paradajz/Zvuk9/hw/Zvuk9_R2.pdf

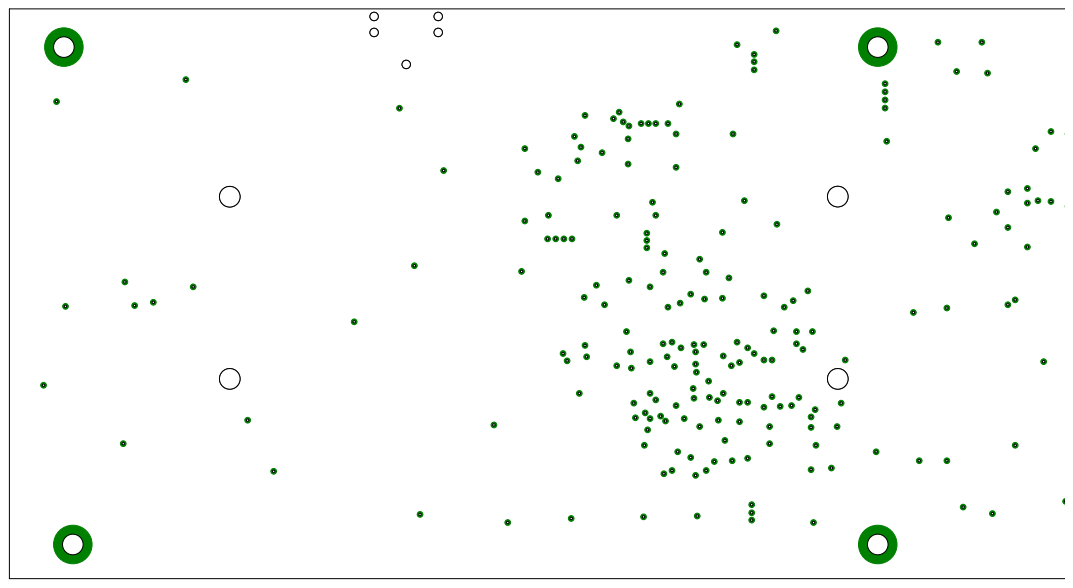
[picture p1: page 1]

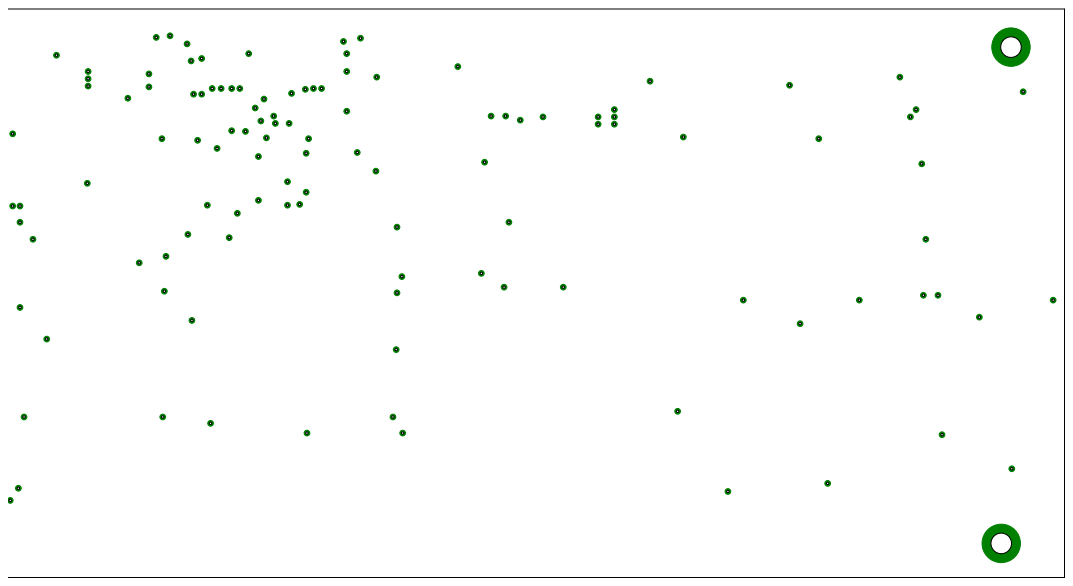
[picture p2: page 2]
