paradajz/Zvuk9/hw/Zvuk9_R2.brd

## EAGLE design hw/Zvuk9_R2.brd (2021-06-12)

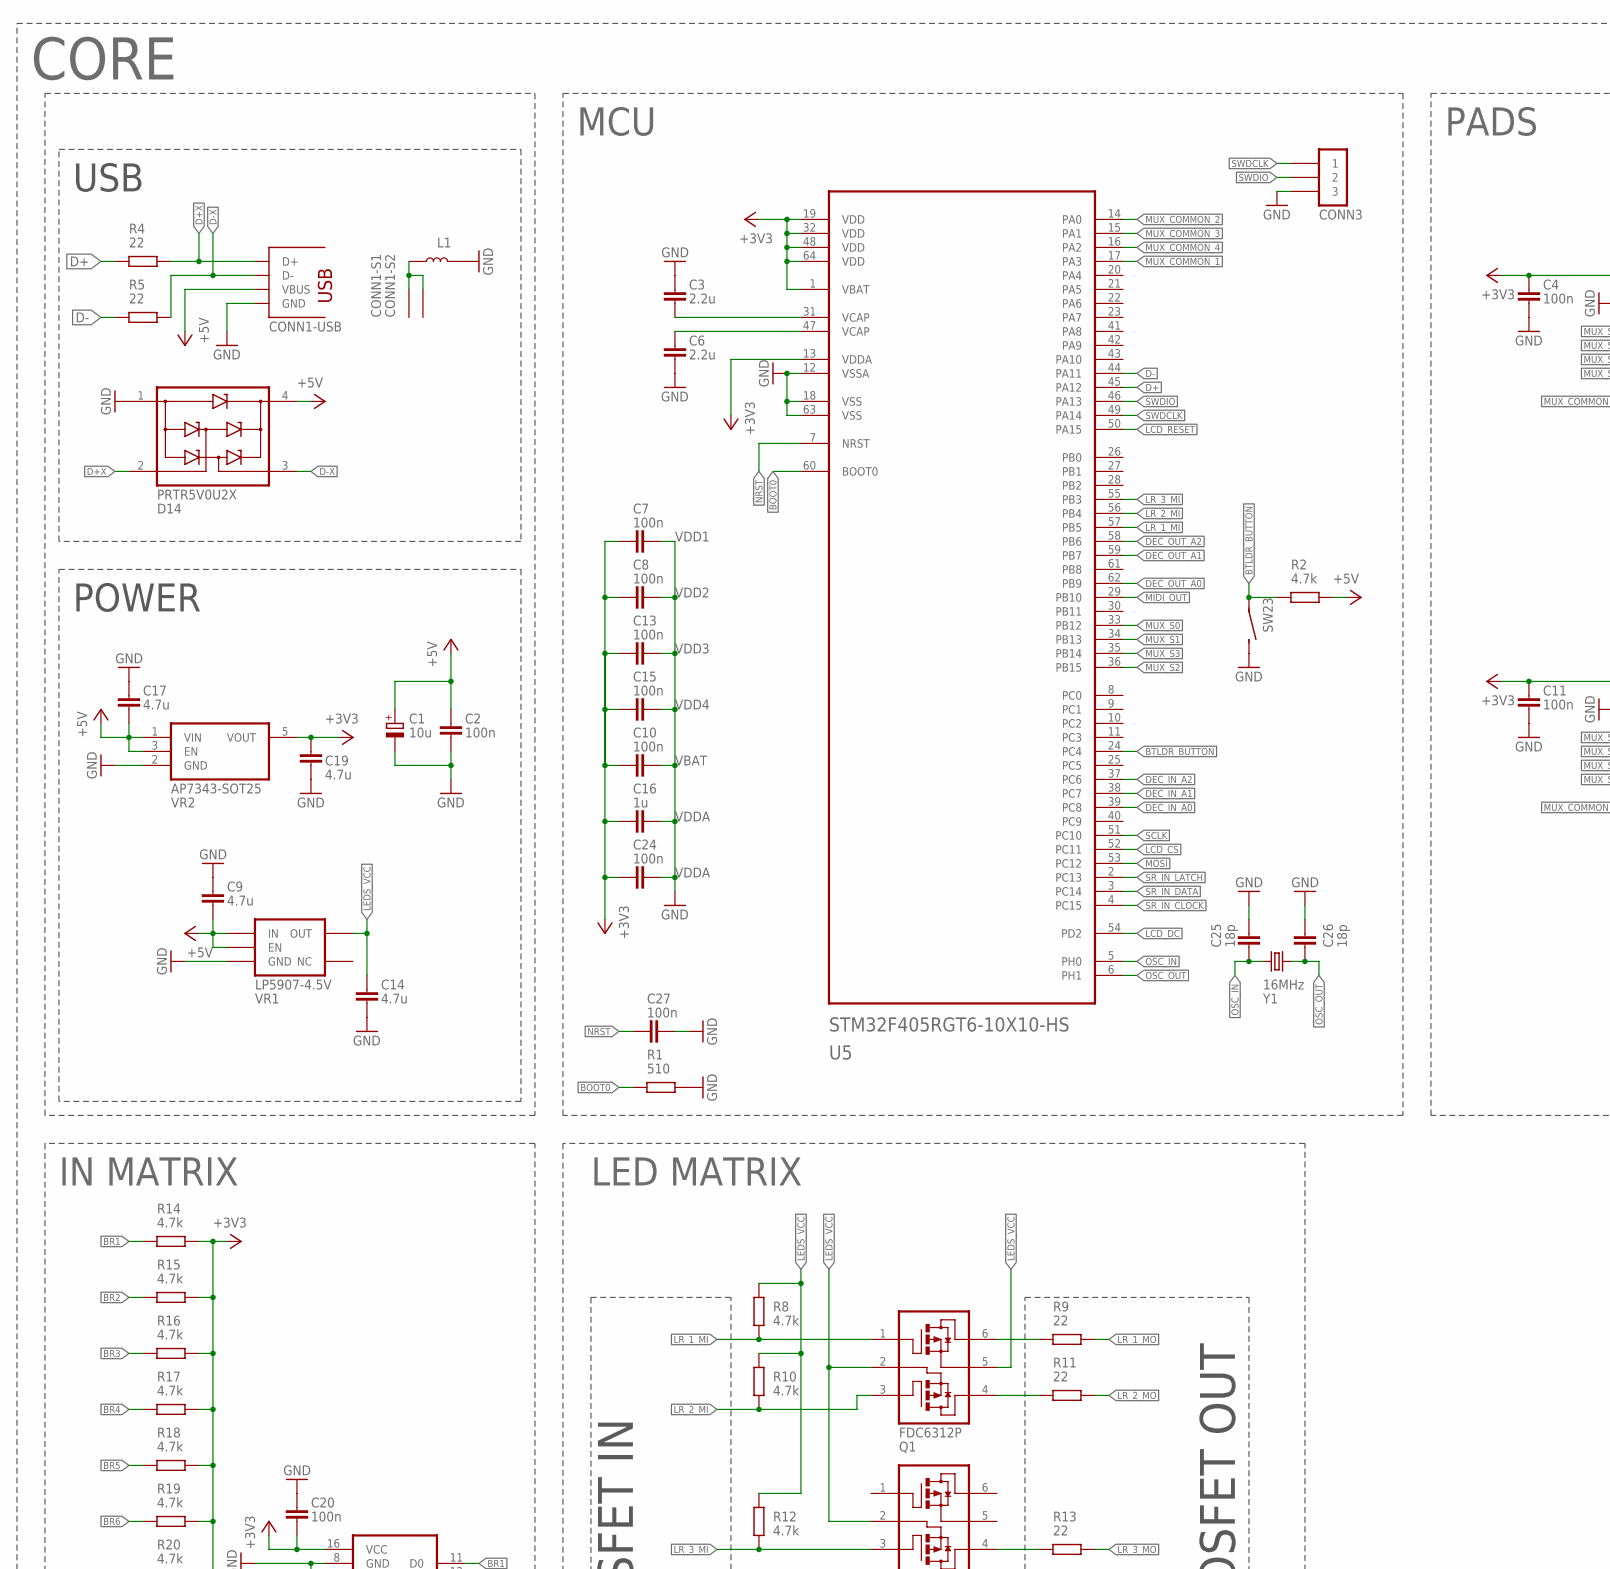
[picture p3: schematic Zvuk9_R2.sch, part in row 1, column 1]

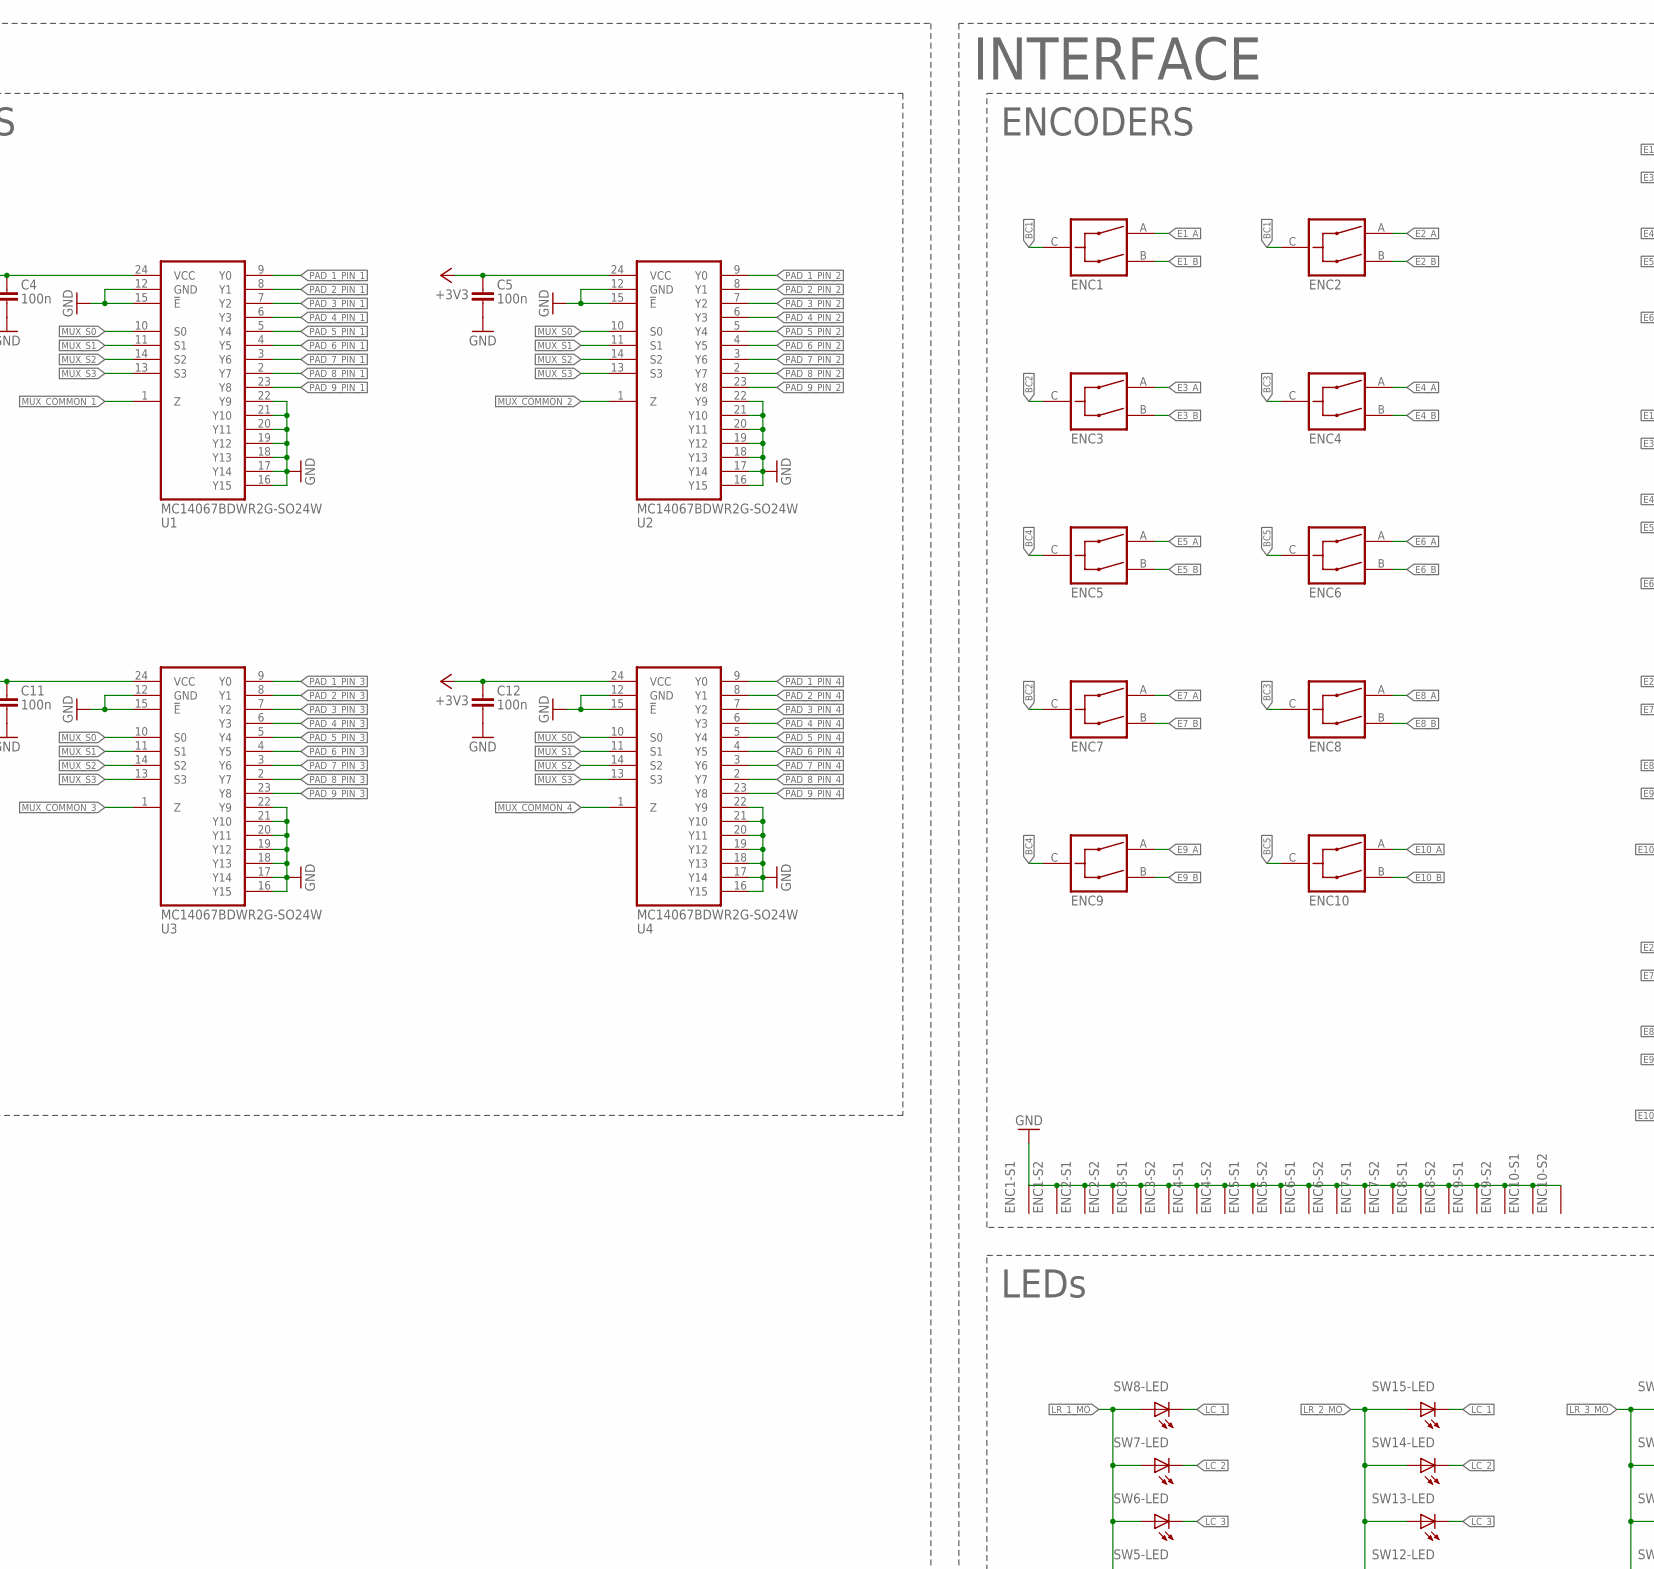
[picture p4: schematic Zvuk9_R2.sch, part in row 1, column 2]

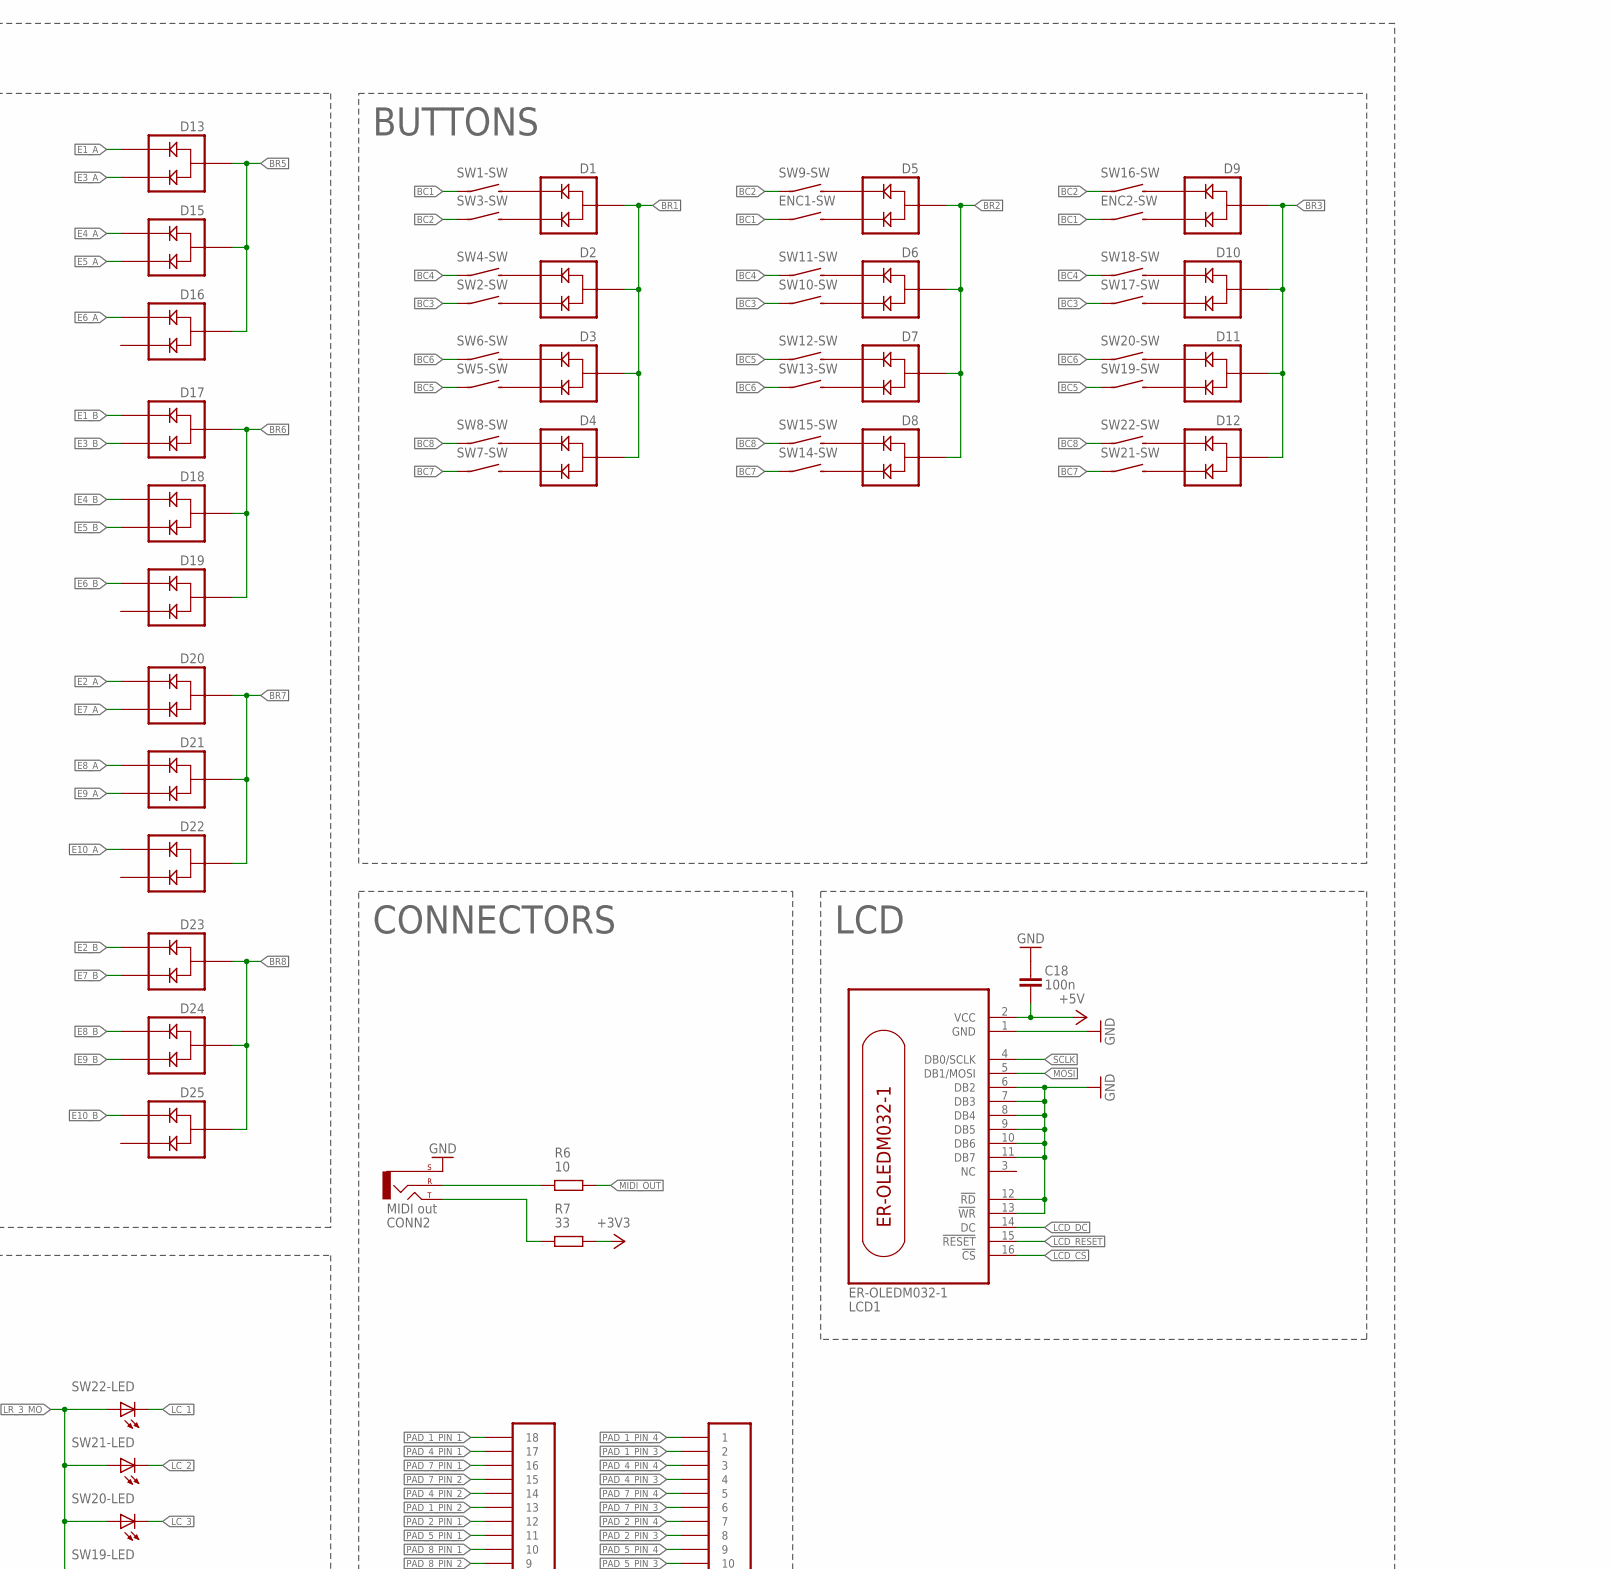
[picture p5: schematic Zvuk9_R2.sch, part in row 1, column 3]

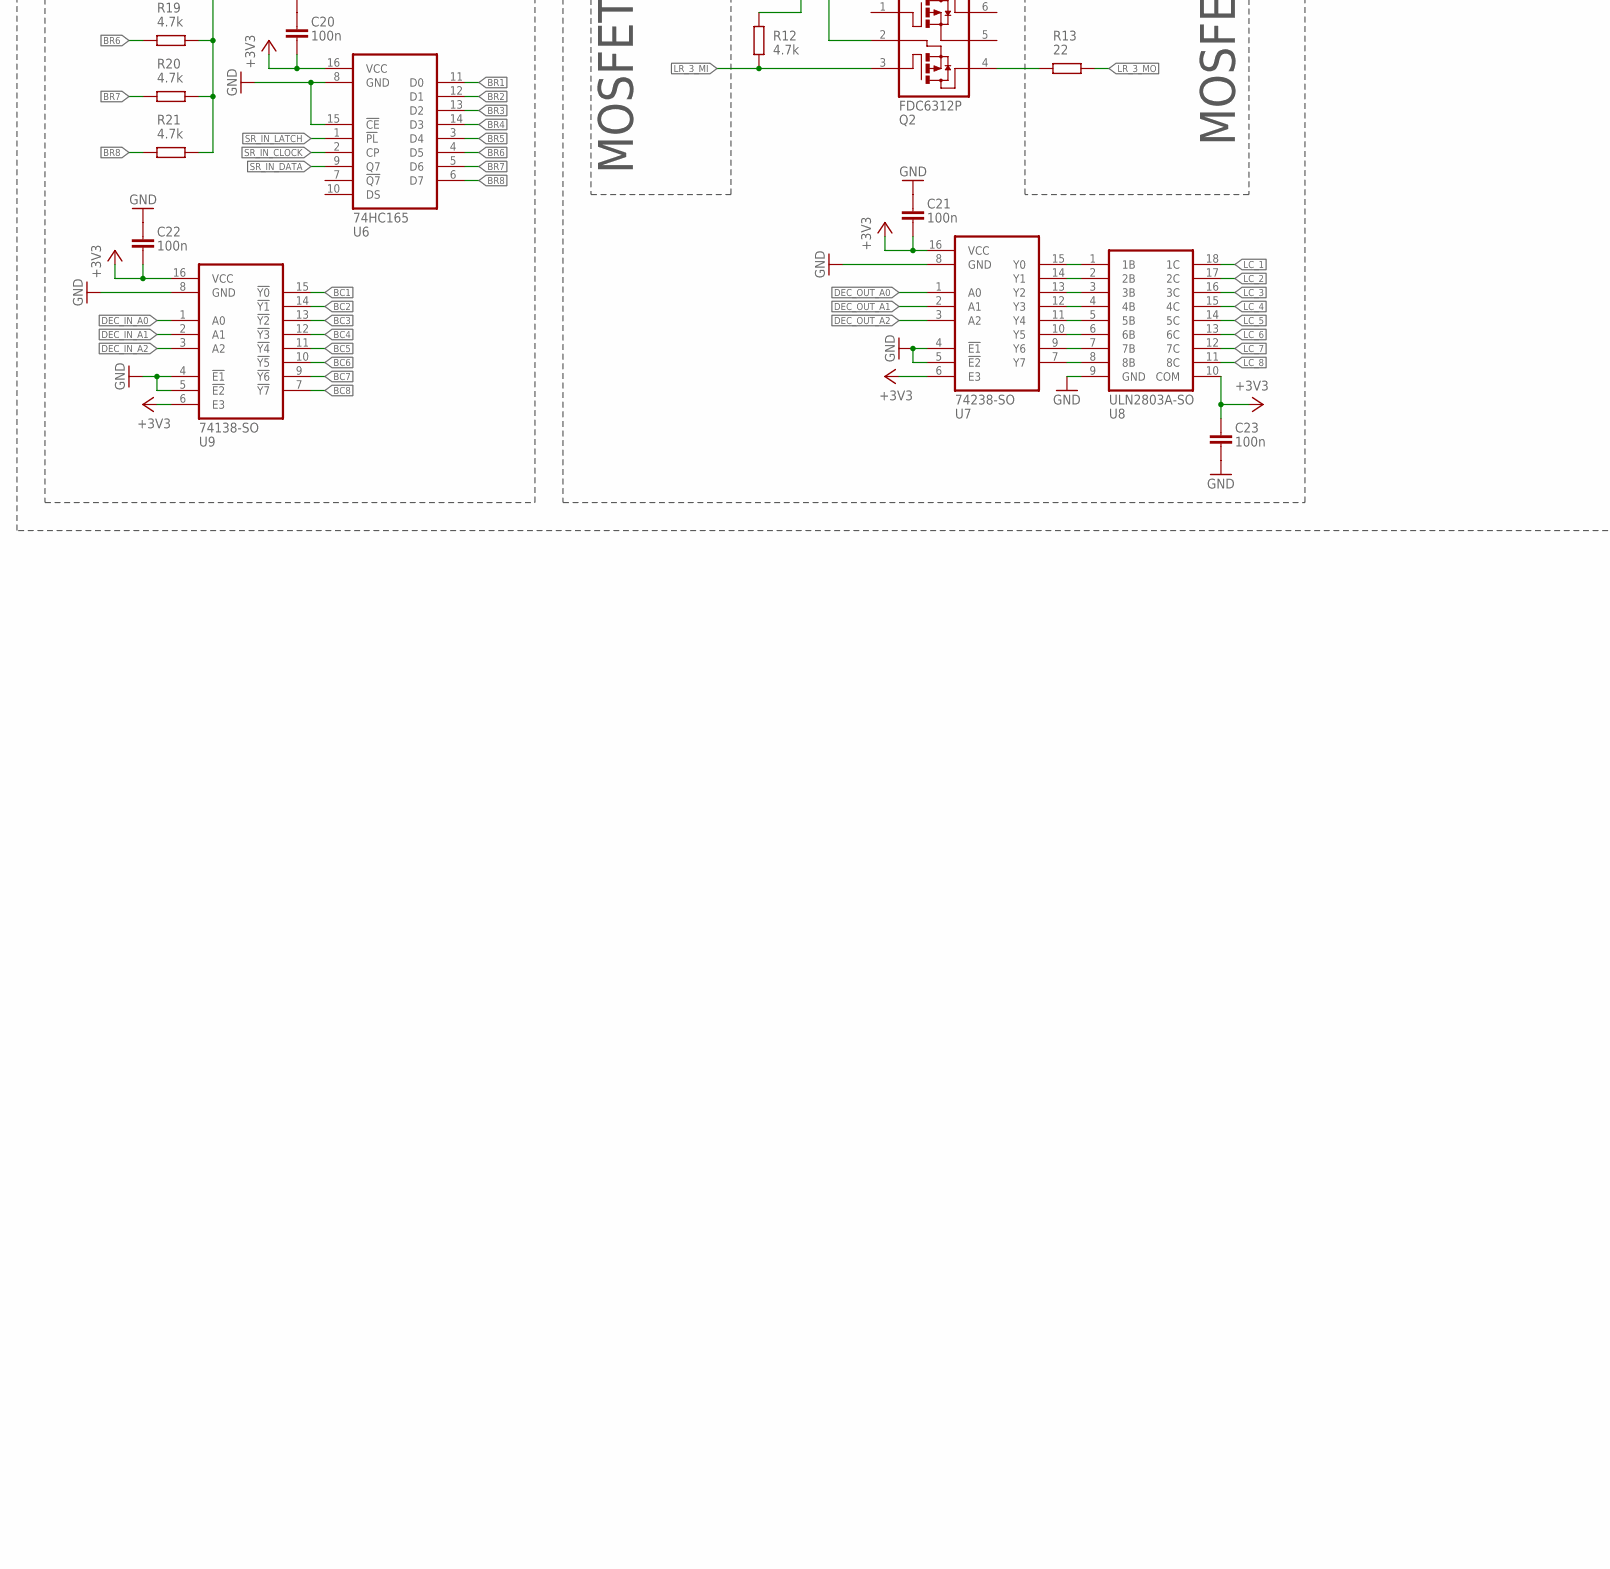
[picture p6: schematic Zvuk9_R2.sch, part in row 2, column 1]

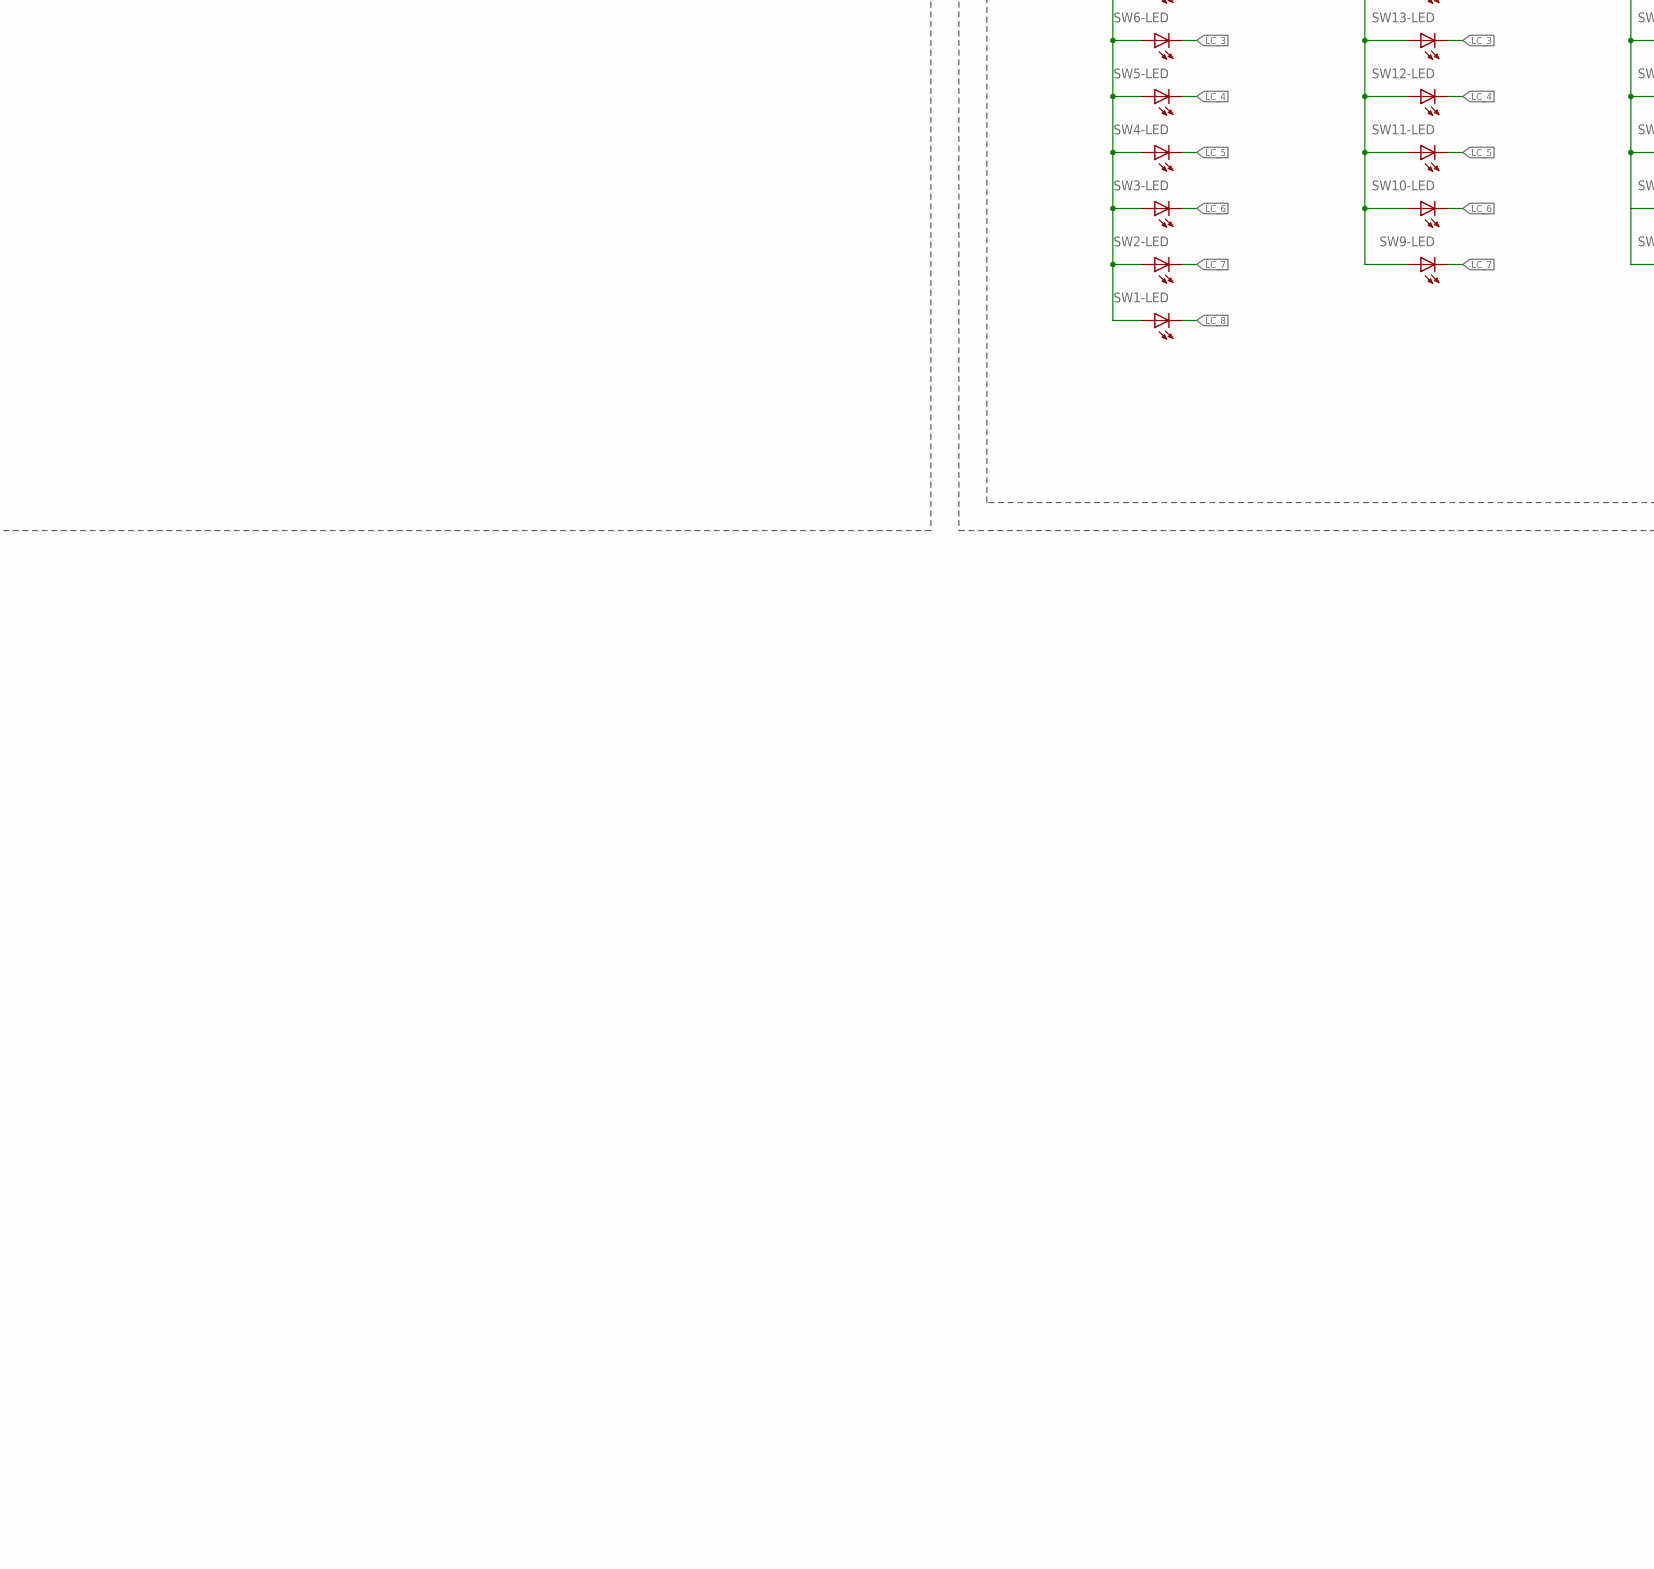
[picture p7: schematic Zvuk9_R2.sch, part in row 2, column 2]

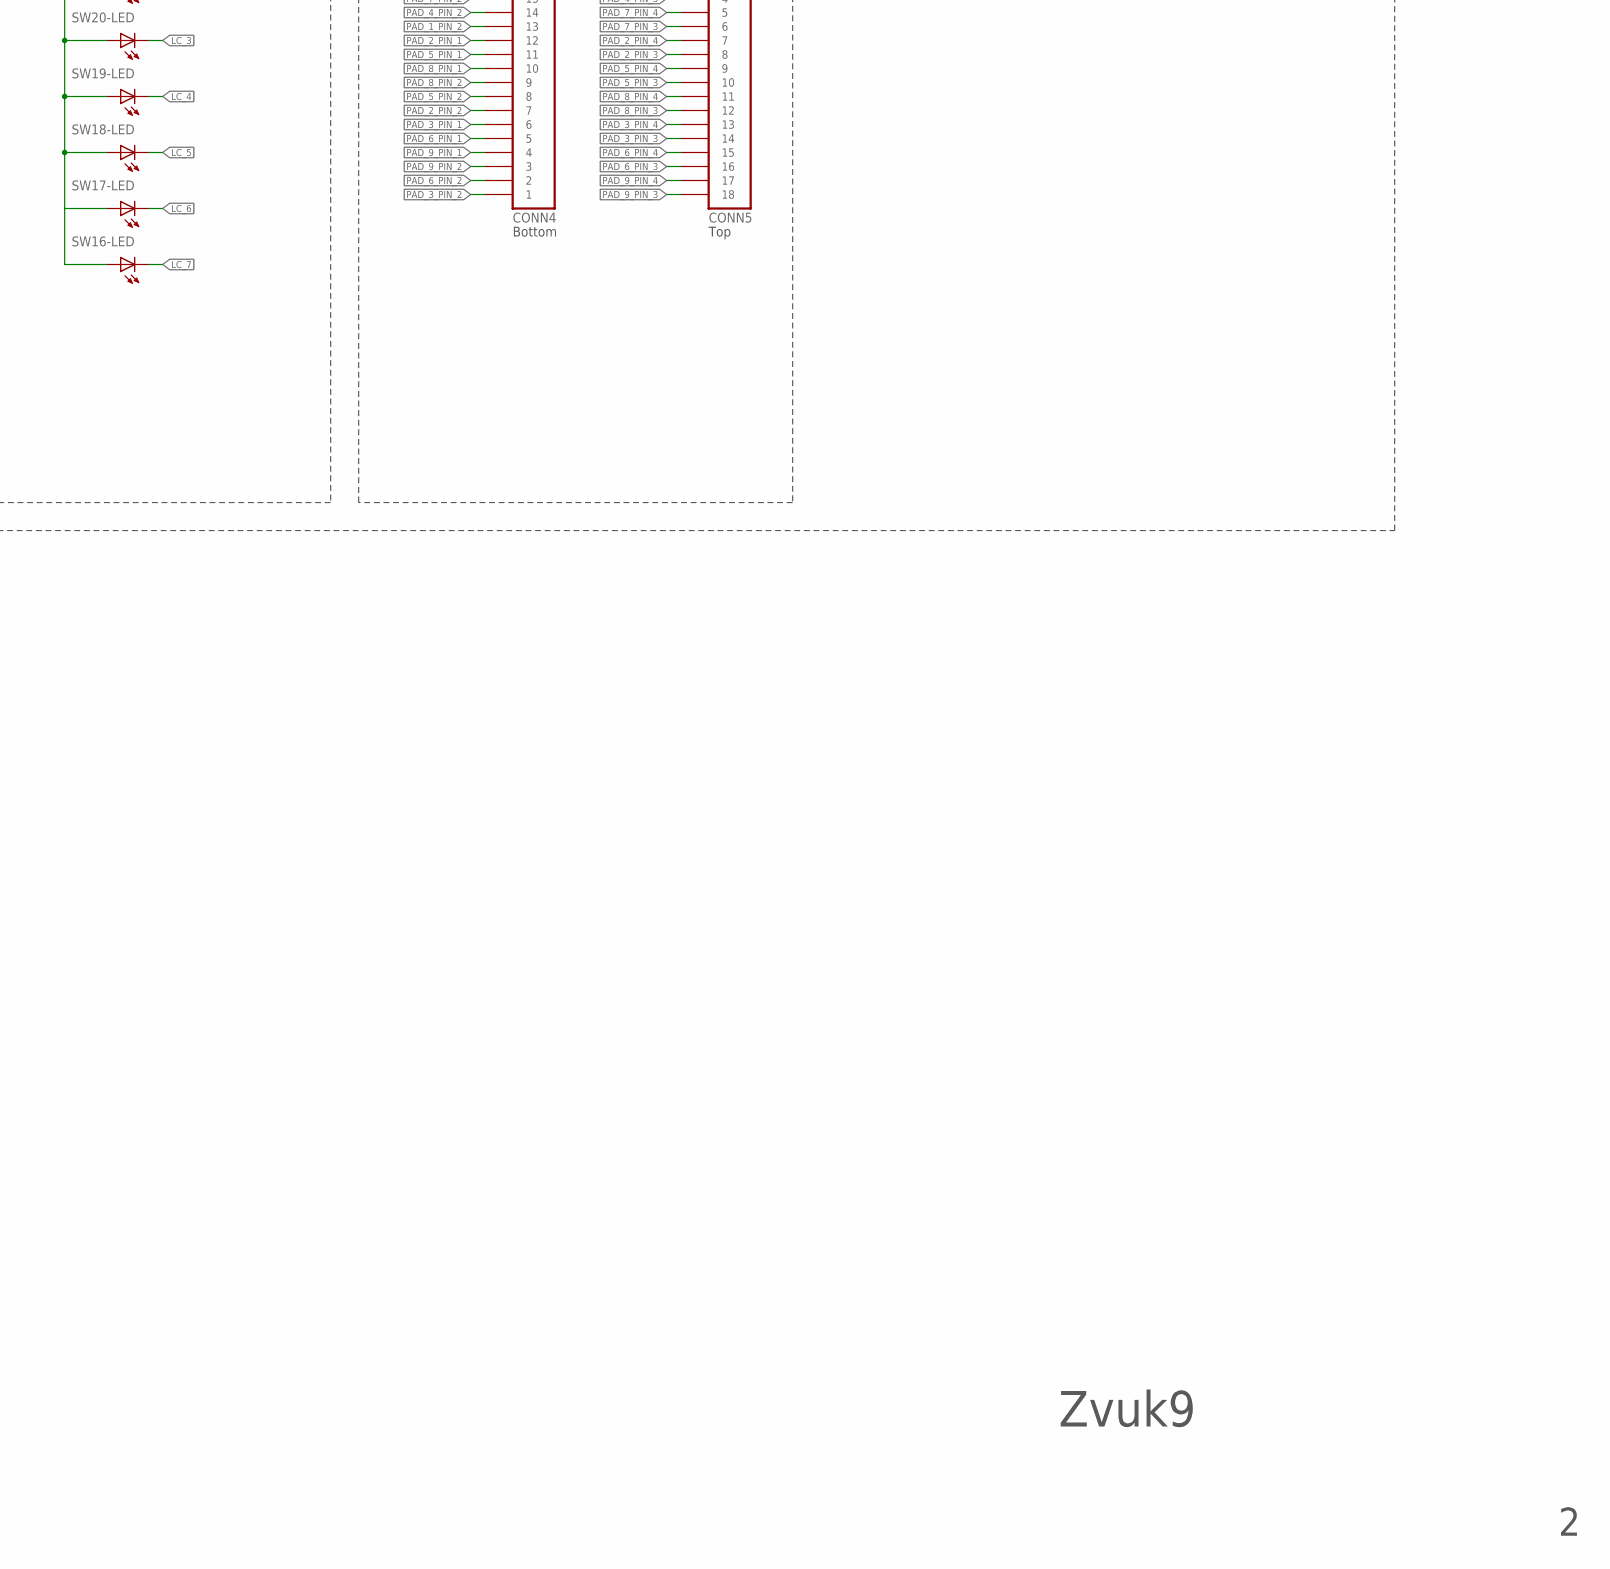
[picture p8: schematic Zvuk9_R2.sch, part in row 2, column 3]

Parts:
C1: 10u; C-TH-E-0502
C2, C4, C5, C7, C8, C10, C11, C12, C13, C15, C18, C20, C21, C22, C23, C24, C27: 100n; C0805
C3, C6: 2.2u; C0805
C9, C14, C17, C19: 4.7u; C0805
C16: 1u; C0805
C25, C26: 18p; C0805
CONN1: USB-B-H; USB-B-PTH
CONN2: MIDI out; SJ1-3523N
CONN3: PINHD-1X03-TH-2.54MM; 1X03-2.54-V
CONN4, CONN5: PINHD-1X18-FFC-SMD-1MM; MOLEX-52271-1879
D1, D2, D3, D4, D5, D6, D7, D8, D9, D10, D11, D12, D13, D15, D16, D17, D18, D19, D20, D21, D22, D23, D24, D25: BAW56; SOT23
D14: PRTR5V0U2X; SOT143
ENC1, ENC2: ALPS-EC12D1524403; ALPS_EC12-SW
ENC3, ENC4, ENC5, ENC6, ENC7, ENC8, ENC9, ENC10: ALPS-EC12E24404AX; EC12E-1
L1: FERRITE_BEAD-BLM21PG221SN1D; L0805
LCD1: ER-OLEDM032-1; ER-OLEDM032-W
Q1, Q2: FDC6312P; SSOT6
R1: 510; R0805
R2, R8, R10, R12, R14, R15, R16, R17, R18, R19, R20, R21: 4.7k; R0805
R4, R5, R9, R11, R13: 22; R0805
R6: 10; R0805
R7: 33; R0805
SW1, SW2, SW3, SW4, SW5, SW6, SW7, SW8, SW9, SW10, SW11, SW12, SW13, SW14, SW15, SW16, SW17, SW18, SW19, SW20, SW21, SW22: OMRON-B3W-9
SW23: SWITCH-B3F; B3F-312X
U1, U2, U3, U4: MC14067BDWR2G-SO24W; SO24-W
U5: STM32F405RGT6-10X10-HS; TQFP-64-10X10-HS
U6: 74HC165; SO16
U7: 74238-SO; SO16
U8: ULN2803A-SO; SO18
U9: 74138-SO; SO16
VR1: LP5907-4.5V; SOT23-5
VR2: AP7343-SOT25; SOT25
Y1: 16MHz; HC49US

Connections:
+3V3: C4.1, C5.1, C7.1, C8.1, C10.1, C11.1, C12.1, C13.1, C15.1, C16.1, C19.1, C20.2, C21.2, C22.2, C23.1, C24.1, R7.2, R14.2, R15.2, R16.2, R17.2, R18.2, R19.2, R20.2, R21.2, U1.24 (VCC), U2.24 (VCC), U3.24 (VCC), U4.24 (VCC), U5.1 (VBAT), U5.13 (VDDA), U5.19 (VDD), U5.32 (VDD), U5.48 (VDD), U5.64 (VDD), U6.16 (VCC), U7.6 (E3), U7.16 (VCC), U8.10 (COM), U9.6 (E3), U9.16 (VCC), VR2.5 (VOUT)
+5V: C1.+, C2.1, C9.2, C17.2, C18.2, CONN1.VBUS, D14.4 (VCC), LCD1.2 (VCC), R2.2, VR1.1 (IN), VR1.3 (EN), VR2.1 (VIN), VR2.3 (EN)
BC1: ENC1.C, ENC1.D (1), ENC2.C, ENC2.D (1), SW1.1, U9.15 (!Y0)
BC2: ENC3.C, ENC7.C, SW3.1, SW9.1, SW16.1, U9.14 (!Y1)
BC3: ENC4.C, ENC8.C, SW2.1, SW10.1, SW17.1, U9.13 (!Y2)
BC4: ENC5.C, ENC9.C, SW4.1, SW11.1, SW18.1, U9.12 (!Y3)
BC5: ENC6.C, ENC10.C, SW5.1, SW12.1, SW19.1, U9.11 (!Y4)
BC6: SW6.1, SW13.1, SW20.1, U9.10 (!Y5)
BC7: SW7.1, SW14.1, SW21.1, U9.9 (!Y6)
BC8: SW8.1, SW15.1, SW22.1, U9.7 (!Y7)
BOOT0: R1.1, U5.60 (BOOT0)
BR1: D1.3, D2.3, D3.3, D4.3, R14.1, U6.11 (D0)
BR2: D5.3, D6.3, D7.3, D8.3, R15.1, U6.12 (D1)
BR3: D9.3, D10.3, D11.3, D12.3, R16.1, U6.13 (D2)
BR4: R17.1, U6.14 (D3)
BR5: D13.3, D15.3, D16.3, R18.1, U6.3 (D4)
BR6: D17.3, D18.3, D19.3, R19.1, U6.4 (D5)
BR7: D20.3, D21.3, D22.3, R20.1, U6.5 (D6)
BR8: D23.3, D24.3, D25.3, R21.1, U6.6 (D7)
BTLDR_BUTTON: R2.1, SW23.1, U5.24 (PC4)
D+: R4.1, U5.45 (PA12)
D+X: CONN1.D+, D14.2 (I/O1), R4.2
D-: R5.1, U5.44 (PA11)
D-X: CONN1.D-, D14.3 (I/O2), R5.2
DEC_IN_A0: U5.39 (PC8), U9.1 (A0)
DEC_IN_A1: U5.38 (PC7), U9.2 (A1)
DEC_IN_A2: U5.37 (PC6), U9.3 (A2)
DEC_OUT_A0: U5.62 (PB9), U7.1 (A0)
DEC_OUT_A1: U5.59 (PB7), U7.2 (A1)
DEC_OUT_A2: U5.58 (PB6), U7.3 (A2)
E1_A: D13.1, ENC1.A
E1_B: D17.1, ENC1.B
E2_A: D20.1, ENC2.A
E2_B: D23.1, ENC2.B
E3_A: D13.2, ENC3.A
E3_B: D17.2, ENC3.B
E4_A: D15.1, ENC4.A
E4_B: D18.1, ENC4.B
E5_A: D15.2, ENC5.A
E5_B: D18.2, ENC5.B
E6_A: D16.1, ENC6.A
E6_B: D19.1, ENC6.B
E7_A: D20.2, ENC7.A
E7_B: D23.2, ENC7.B
E8_A: D21.1, ENC8.A
E8_B: D24.1, ENC8.B
E9_A: D21.2, ENC9.A
E9_B: D24.2, ENC9.B
E10_A: D22.1, ENC10.A
E10_B: D25.1, ENC10.B
GND: C1.-, C2.2, C3.1, C4.2, C5.2, C6.2, C7.2, C8.2, C9.1, C10.2, C11.2, C12.2, C13.2, C14.2, C15.2, C16.2, C17.1, C18.1, C19.2, C20.1, C21.1, C22.1, C23.2, C24.2, C25.2, C26.2, C27.2, CONN1.GND, CONN2.1 (SLEEVE), CONN3.3, D14.1 (GND), ENC1.S1 (S), ENC1.S2 (S), ENC2.S1 (S), ENC2.S2 (S), ENC3.S1 (S), ENC3.S2 (S), ENC4.S1 (S), ENC4.S2 (S), ENC5.S1 (S), ENC5.S2 (S), ENC6.S1 (S), ENC6.S2 (S), ENC7.S1 (S), ENC7.S2 (S), ENC8.S1 (S), ENC8.S2 (S), ENC9.S1 (S), ENC9.S2 (S), ENC10.S1 (S), ENC10.S2 (S), L1.2, LCD1.1 (GND), LCD1.6 (DB2), LCD1.7 (DB3), LCD1.8 (DB4), LCD1.9 (DB5), LCD1.10 (DB6), LCD1.11 (DB7), LCD1.12 (!RD), LCD1.13 (!WR), R1.2, SW23.2, U1.12 (GND), U1.15 (!E), U1.16 (Y15), U1.17 (Y14), U1.18 (Y13), U1.19 (Y12), U1.20 (Y11), U1.21 (Y10), U1.22 (Y9), U2.12 (GND), U2.15 (!E), U2.16 (Y15), U2.17 (Y14), U2.18 (Y13), U2.19 (Y12), U2.20 (Y11), U2.21 (Y10), U2.22 (Y9), U3.12 (GND), U3.15 (!E), U3.16 (Y15), U3.17 (Y14), U3.18 (Y13), U3.19 (Y12), U3.20 (Y11), U3.21 (Y10), U3.22 (Y9), U4.12 (GND), U4.15 (!E), U4.16 (Y15), U4.17 (Y14), U4.18 (Y13), U4.19 (Y12), U4.20 (Y11), U4.21 (Y10), U4.22 (Y9), U5.12 (VSSA), U5.18 (VSS), U5.63 (VSS), U6.8 (GND), U6.15 (!CE), U7.4 (!E1), U7.5 (!E2), U7.8 (GND), U8.9 (GND), U9.4 (!E1), U9.5 (!E2), U9.8 (GND), VR1.2 (GND), VR2.2 (GND)
LCD_CS: LCD1.16 (!CS), U5.52 (PC11)
LCD_DC: LCD1.14 (DC), U5.54 (PD2)
LCD_RESET: LCD1.15 (!RESET), U5.50 (PA15)
LC_1: SW8.6-C (C), SW15.6-C (C), SW22.6-C (C), U8.18 (1C)
LC_2: SW7.6-C (C), SW14.6-C (C), SW21.6-C (C), U8.17 (2C)
LC_3: SW6.6-C (C), SW13.6-C (C), SW20.6-C (C), U8.16 (3C)
LC_4: SW5.6-C (C), SW12.6-C (C), SW19.6-C (C), U8.15 (4C)
LC_5: SW4.6-C (C), SW11.6-C (C), SW18.6-C (C), U8.14 (5C)
LC_6: SW3.6-C (C), SW10.6-C (C), SW17.6-C (C), U8.13 (6C)
LC_7: SW2.6-C (C), SW9.6-C (C), SW16.6-C (C), U8.12 (7C)
LC_8: SW1.6-C (C), U8.11 (8C)
LEDS_VCC: C14.1, Q1.2 (S2), Q1.5 (S1), Q2.2 (S2), R8.1, R10.1, R12.1, VR1.5 (OUT)
LR_1_MI: Q1.1 (G1), R8.2, U5.57 (PB5)
LR_1_MO: R9.2, SW1.6-A (A), SW2.6-A (A), SW3.6-A (A), SW4.6-A (A), SW5.6-A (A), SW6.6-A (A), SW7.6-A (A), SW8.6-A (A)
LR_2_MI: Q1.3 (G2), R10.2, U5.56 (PB4)
LR_2_MO: R11.2, SW9.6-A (A), SW10.6-A (A), SW11.6-A (A), SW12.6-A (A), SW13.6-A (A), SW14.6-A (A), SW15.6-A (A)
LR_3_MI: Q2.3 (G2), R12.2, U5.55 (PB3)
LR_3_MO: R13.2, SW16.6-A (A), SW17.6-A (A), SW18.6-A (A), SW19.6-A (A), SW20.6-A (A), SW21.6-A (A), SW22.6-A (A)
MIDI_OUT: R6.2, U5.29 (PB10)
MOSI: LCD1.5 (DB1/MOSI), U5.53 (PC12)
MUX_COMMON_1: U1.1 (Z), U5.17 (PA3)
MUX_COMMON_2: U2.1 (Z), U5.14 (PA0)
MUX_COMMON_3: U3.1 (Z), U5.15 (PA1)
MUX_COMMON_4: U4.1 (Z), U5.16 (PA2)
MUX_S0: U1.10 (S0), U2.10 (S0), U3.10 (S0), U4.10 (S0), U5.33 (PB12)
MUX_S1: U1.11 (S1), U2.11 (S1), U3.11 (S1), U4.11 (S1), U5.34 (PB13)
MUX_S2: U1.14 (S2), U2.14 (S2), U3.14 (S2), U4.14 (S2), U5.36 (PB15)
MUX_S3: U1.13 (S3), U2.13 (S3), U3.13 (S3), U4.13 (S3), U5.35 (PB14)
unnamed: U7.15 (Y0), U8.1 (1B)
unnamed: U7.14 (Y1), U8.2 (2B)
unnamed: U7.13 (Y2), U8.3 (3B)
unnamed: U7.12 (Y3), U8.4 (4B)
unnamed: D1.1, SW1.3 (2)
unnamed: D2.2, SW2.3 (2)
unnamed: CONN2.2 (TIP), R7.1
unnamed: D2.1, SW4.3 (2)
unnamed: D1.2, SW3.3 (2)
unnamed: D3.2, SW5.3 (2)
unnamed: D3.1, SW6.3 (2)
unnamed: C3.2, U5.31 (VCAP)
unnamed: C6.1, U5.47 (VCAP)
unnamed: D4.2, SW7.3 (2)
unnamed: D4.1, SW8.3 (2)
unnamed: D5.2, ENC1.E (2)
unnamed: D6.2, SW10.3 (2)
unnamed: D6.1, SW11.3 (2)
unnamed: D7.1, SW12.3 (2)
unnamed: D7.2, SW13.3 (2)
unnamed: D8.2, SW14.3 (2)
unnamed: D8.1, SW15.3 (2)
unnamed: D5.1, SW9.3 (2)
unnamed: D9.2, ENC2.E (2)
unnamed: D9.1, SW16.3 (2)
unnamed: D10.2, SW17.3 (2)
unnamed: D10.1, SW18.3 (2)
unnamed: D11.2, SW19.3 (2)
unnamed: D11.1, SW20.3 (2)
unnamed: D12.2, SW21.3 (2)
unnamed: D12.1, SW22.3 (2)
unnamed: CONN2.3 (RING), R6.1
unnamed: U7.11 (Y4), U8.5 (5B)
unnamed: U7.10 (Y5), U8.6 (6B)
unnamed: U7.9 (Y6), U8.7 (7B)
unnamed: U7.7 (Y7), U8.8 (8B)
unnamed: Q1.6 (D1), R9.1
unnamed: Q1.4 (D2), R11.1
unnamed: Q2.4 (D2), R13.1
NRST: C27.1, U5.7 (NRST)
OSC_IN: C25.1, U5.5 (PH0), Y1.1
OSC_OUT: C26.1, U5.6 (PH1), Y1.2
PAD_1_PIN_1: CONN4.18, U1.9 (Y0)
PAD_1_PIN_2: CONN4.13, U2.9 (Y0)
PAD_1_PIN_3: CONN5.2, U3.9 (Y0)
PAD_1_PIN_4: CONN5.1, U4.9 (Y0)
PAD_2_PIN_1: CONN4.12, U1.8 (Y1)
PAD_2_PIN_2: CONN4.7, U2.8 (Y1)
PAD_2_PIN_3: CONN5.8, U3.8 (Y1)
PAD_2_PIN_4: CONN5.7, U4.8 (Y1)
PAD_3_PIN_1: CONN4.6, U1.7 (Y2)
PAD_3_PIN_2: CONN4.1, U2.7 (Y2)
PAD_3_PIN_3: CONN5.14, U3.7 (Y2)
PAD_3_PIN_4: CONN5.13, U4.7 (Y2)
PAD_4_PIN_1: CONN4.17, U1.6 (Y3)
PAD_4_PIN_2: CONN4.14, U2.6 (Y3)
PAD_4_PIN_3: CONN5.4, U3.6 (Y3)
PAD_4_PIN_4: CONN5.3, U4.6 (Y3)
PAD_5_PIN_1: CONN4.11, U1.5 (Y4)
PAD_5_PIN_2: CONN4.8, U2.5 (Y4)
PAD_5_PIN_3: CONN5.10, U3.5 (Y4)
PAD_5_PIN_4: CONN5.9, U4.5 (Y4)
PAD_6_PIN_1: CONN4.5, U1.4 (Y5)
PAD_6_PIN_2: CONN4.2, U2.4 (Y5)
PAD_6_PIN_3: CONN5.16, U3.4 (Y5)
PAD_6_PIN_4: CONN5.15, U4.4 (Y5)
PAD_7_PIN_1: CONN4.16, U1.3 (Y6)
PAD_7_PIN_2: CONN4.15, U2.3 (Y6)
PAD_7_PIN_3: CONN5.6, U3.3 (Y6)
PAD_7_PIN_4: CONN5.5, U4.3 (Y6)
PAD_8_PIN_1: CONN4.10, U1.2 (Y7)
PAD_8_PIN_2: CONN4.9, U2.2 (Y7)
PAD_8_PIN_3: CONN5.12, U3.2 (Y7)
PAD_8_PIN_4: CONN5.11, U4.2 (Y7)
PAD_9_PIN_1: CONN4.4, U1.23 (Y8)
PAD_9_PIN_2: CONN4.3, U2.23 (Y8)
PAD_9_PIN_3: CONN5.18, U3.23 (Y8)
PAD_9_PIN_4: CONN5.17, U4.23 (Y8)
SCLK: LCD1.4 (DB0/SCLK), U5.51 (PC10)
SR_IN_CLOCK: U5.4 (PC15), U6.2 (CP)
SR_IN_DATA: U5.3 (PC14), U6.9 (Q7)
SR_IN_LATCH: U5.2 (PC13), U6.1 (!PL)
SWDCLK: CONN3.1, U5.49 (PA14)
SWDIO: CONN3.2, U5.46 (PA13)
USB_SHIELD: CONN1.S1 (S), CONN1.S2 (S), L1.1

Notes on the sheet:
LCD
BUTTONS
ENCODERS
CONNECTORS
Zvuk9
LEDs
USB
MOSFET IN
MOSFET OUT
MCU
POWER
IN MATRIX
LED MATRIX
CORE
INTERFACE
PADS
Bottom
Top
VBAT
VDD1
VDD2
VDD3
VDD4
VDDA

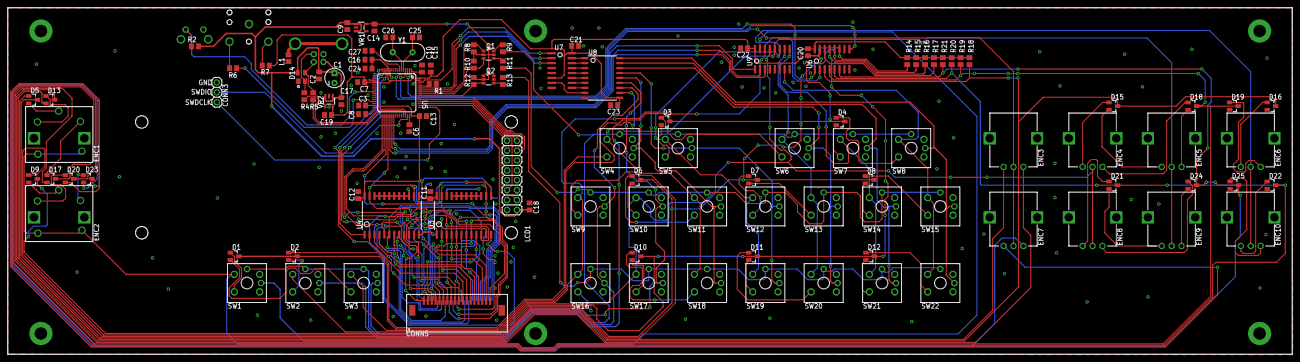
[picture p9: board Zvuk9_R2.brd from above]

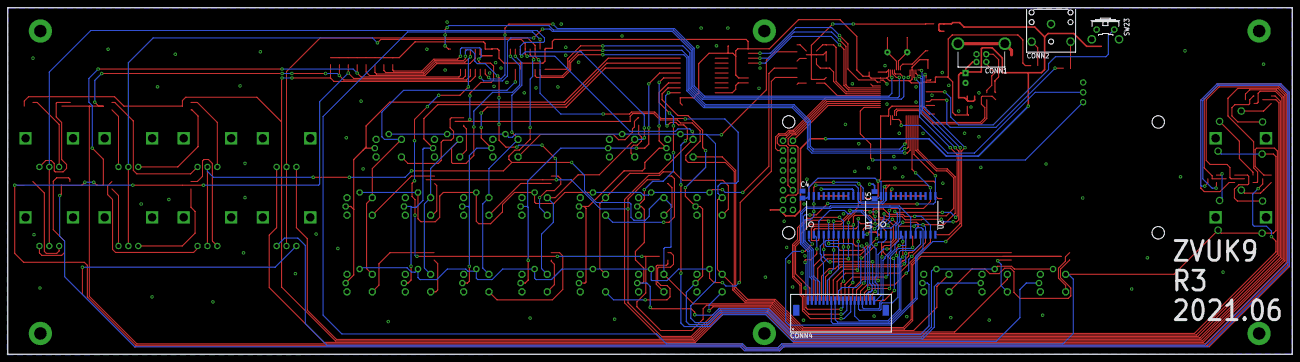
[picture p10: board Zvuk9_R2.brd from below]

Board: 2 copper layers, 330.1 x 89.0 mm, 126 parts (8 on the bottom side), 164 nets.
