paradajz/Zvuk9/src/application/io/encoders/Encoders.cpp

/*
    Zvuk9 MIDI controller
    Copyright (C) 2014-2017 Ad Bit LLC
    Author: Igor Petrović
    
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
    You may ONLY use this file:
    1) if you have a valid commercial Ad Bit LLC license and then in accordance with
    the terms contained in the written license agreement between you and Ad Bit LLC,
    or alternatively
    2) if you follow the terms found in GNU General Public License version 3 as
    published by the Free Software Foundation here
    <https://www.gnu.org/licenses/gpl-3.0.txt>
*/

#include "Encoders.h"
#include "../../../display/menu/Menu.h"
#include "handlers/Handlers.h"
#include "pins/map/Encoders.h"
#include "core/src/general/Timing.h"
#include "board/Board.h"

/// \ingroup interfaceEncoders
/// @{

/// External definition of function pointers used as handlers for encoders.
extern void (*encoderHandler[MAX_NUMBER_OF_ENCODERS])(uint8_t id, int8_t steps);

/// When set to true, preset encoder is used to change MIDI channels instead of presets.
bool midiChannelEncState;

/// Array holding last time in milliseconds encoders were moved.
uint32_t lastStepTime[MAX_NUMBER_OF_ENCODERS];

/// Array holding current speed (in steps) for all encoders.
/// Set to 1 by default.
int8_t encoderSpeed[MAX_NUMBER_OF_ENCODERS];

/// @}

/// Default constructor.
Encoders::Encoders()
{
}

/// Initializes Encoders object.
void Encoders::init()
{
    initHandlers_encoders();
}

/// Continuously checks state of all encoders.
void Encoders::update(bool process)
{
    int8_t steps;

    for (int i = 0; i < MAX_NUMBER_OF_ENCODERS; i++)
    {
        //process only enabled encoders
        if (!board.encoderEnabled(i))
            continue;

        steps = board.getEncoderState(i);

        if (steps == 0)
            continue;

        //when time difference between two movements is smaller than SPEED_TIMEOUT,
        //start accelerating
        if ((rTimeMs() - lastStepTime[i]) < SPEED_TIMEOUT)
        {
            encoderSpeed[i] += ENCODER_SPEED_CHANGE;
            steps = steps > 0 ? encoderSpeed[i] : -encoderSpeed[i];
        }
        else
        {
            encoderSpeed[i] = 0;
        }

        //allow only program and scale encoder while in menu
        //no message on display? maybe TO-DO
        if (menu.isMenuDisplayed())
        {
            if (!((i == PROGRAM_ENCODER) || (i == X_MAX_ENCODER) || (i == X_MIN_ENCODER) || (i == Y_MAX_ENCODER) || (i == Y_MIN_ENCODER)))
                continue;
        }

        if (encoderHandler[i] != NULL)
        {
            if (process)
                (*encoderHandler[i])(i, steps);
            lastStepTime[i] = rTimeMs();
        }
    }

    //disable midi channel function when regular text gets shown on display
    if (midiChannelEncState && (display.getActiveTextType() == displayText_still))
        midiChannelEncState = false;
}

/// Enables or disables MIDI channel changing mode for preset encoder.
/// @param[in] state    If set to true, preset encoder will be used to change MIDI channels.
///                     Otherwise, presets are changed using this encoder.
void Encoders::setMIDIchannelPresetEncMode(bool state)
{
    midiChannelEncState = state;
}

/// Checks if MIDI channel changing mode for preset encoder is enabled.
/// \returns True if MIDI channel changing mode is enabled, false otherwise.
bool Encoders::getMIDIchannelPresetEncMode()
{
    return midiChannelEncState;
}
