paradajz/Zvuk9/src/application/board/avr/Pins.h

/*
    Zvuk9 MIDI controller
    Copyright (C) 2014-2017 Ad Bit LLC
    Author: Igor Petrović
    
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
    You may ONLY use this file:
    1) if you have a valid commercial Ad Bit LLC license and then in accordance with
    the terms contained in the written license agreement between you and Ad Bit LLC,
    or alternatively
    2) if you follow the terms found in GNU General Public License version 3 as
    published by the Free Software Foundation here
    <https://www.gnu.org/licenses/gpl-3.0.txt>
*/

#pragma once

///
/// \brief Pin definitions.
/// \defgroup boardPins Pins
/// \ingroup boardAVR
/// @{

#define MUX_COMMON_PIN_0_PORT       PORTF
#define MUX_COMMON_PIN_0_PIN        7

#define MUX_COMMON_PIN_1_PORT       PORTF
#define MUX_COMMON_PIN_1_PIN        5

#define MUX_COMMON_PIN_2_PORT       PORTF
#define MUX_COMMON_PIN_2_PIN        6

#define MUX_COMMON_PIN_3_PORT       PORTF
#define MUX_COMMON_PIN_3_PIN        4

///
/// \brief Symbolic names for common mux ports.
/// @{

#define PAD_PLATE_X_PLUS_PORT       MUX_COMMON_PIN_0_PORT
#define PAD_PLATE_X_PLUS_PIN        MUX_COMMON_PIN_0_PIN

#define PAD_PLATE_X_MINUS_PORT      MUX_COMMON_PIN_1_PORT
#define PAD_PLATE_X_MINUS_PIN       MUX_COMMON_PIN_1_PIN

#define PAD_PLATE_Y_PLUS_PORT       MUX_COMMON_PIN_2_PORT
#define PAD_PLATE_Y_PLUS_PIN        MUX_COMMON_PIN_2_PIN

#define PAD_PLATE_Y_MINUS_PORT      MUX_COMMON_PIN_3_PORT
#define PAD_PLATE_Y_MINUS_PIN       MUX_COMMON_PIN_3_PIN

/// @}

#define MUX_SELECT_PIN_0_PORT       PORTF
#define MUX_SELECT_PIN_0_PIN        1

#define MUX_SELECT_PIN_1_PORT       PORTF
#define MUX_SELECT_PIN_1_PIN        0

#define MUX_SELECT_PIN_2_PORT       PORTF
#define MUX_SELECT_PIN_2_PIN        2

#define MUX_SELECT_PIN_3_PORT       PORTF
#define MUX_SELECT_PIN_3_PIN        3

#define LED_ROW_1_PORT              PORTB
#define LED_ROW_1_PIN               4

#define LED_ROW_2_PORT              PORTB
#define LED_ROW_2_PIN               5

#define LED_ROW_3_PORT              PORTB
#define LED_ROW_3_PIN               6

#define DECODER_OUT_1_PORT          PORTC
#define DECODER_OUT_1_PIN           0

#define DECODER_OUT_2_PORT          PORTC
#define DECODER_OUT_2_PIN           1

#define DECODER_OUT_3_PORT          PORTC
#define DECODER_OUT_3_PIN           2

#define DECODER_OUT_PORT            PORTC

///
/// Used to clear all select bits in decoder which controls columns in LED matrix.
/// This exploits the fact that all three decoder pins are on the same port on MCU,
/// wired consecutively.
///
#define DECODER_OUT_CLEAR_MASK      0b11111000

///
/// \brief Array holding all 8 states for output decoder.
/// Used to manipulate decoder select pins in a faster way.
///
const uint8_t decoderOutOrderArray[] =
{
    0b00000000,
    0b00000001,
    0b00000010,
    0b00000011,
    0b00000100,
    0b00000101,
    0b00000110,
    0b00000111
};

#define DECODER_IN_A0_PORT          PORTC
#define DECODER_IN_A0_PIN           3

#define DECODER_IN_A1_PORT          PORTC
#define DECODER_IN_A1_PIN           4

#define DECODER_IN_A2_PORT          PORTC
#define DECODER_IN_A2_PIN           5

#define DECODER_IN_PORT             PORTC

///
/// Used to clear all select bits in decoder which controls columns in button matrix.
/// This exploits the fact that all three decoder pins are on the same port on MCU,
/// wired consecutively.
///
#define DECODER_IN_CLEAR_MASK       0b11000111

///
/// \brief Array holding all 8 states for input decoder.
/// Used to manipulate decoder select pins in a faster way.
///
const uint8_t decoderInOrderArray[] =
{
    0b00000000,
    0b00001000,
    0b00010000,
    0b00011000,
    0b00100000,
    0b00101000,
    0b00110000,
    0b00111000
};

#define INPUT_SHIFT_REG_IN_PORT     PORTD
#define INPUT_SHIFT_REG_IN_PIN      5

#define INPUT_SHIFT_REG_CLOCK_PORT  PORTD
#define INPUT_SHIFT_REG_CLOCK_PIN   6

#define INPUT_SHIFT_REG_LATCH_PORT  PORTD
#define INPUT_SHIFT_REG_LATCH_PIN   7

#define DISPLAY_DC_PORT             PORTA
#define DISPLAY_DC_PIN              3

#define DISPLAY_CS_PORT             PORTA
#define DISPLAY_CS_PIN              4

#define DISPLAY_RESET_PORT          PORTA
#define DISPLAY_RESET_PIN           5

#define SPI_CLOCK_PORT              PORTB
#define SPI_CLOCK_PIN               1

#define SPI_MOSI_PORT               PORTB
#define SPI_MOSI_PIN                2

#define SPI_SS_PORT                 PORTB
#define SPI_SS_PIN                  0

#define BTLDR_BUTTON_PORT           PORTE
#define BTLDR_BUTTON_PIN            2

/// @}
