paradajz/Zvuk9/src/application/io/display/Display.h

/*
    Zvuk9 MIDI controller
    Copyright (C) 2014-2017 Ad Bit LLC
    Author: Igor Petrović
    
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
    You may ONLY use this file:
    1) if you have a valid commercial Ad Bit LLC license and then in accordance with
    the terms contained in the written license agreement between you and Ad Bit LLC,
    or alternatively
    2) if you follow the terms found in GNU General Public License version 3 as
    published by the Free Software Foundation here
    <https://www.gnu.org/licenses/gpl-3.0.txt>
*/

#pragma once

#include "../analog/pads/Pads.h"
#include "Config.h"
#include "DataTypes.h"
#include "Layout.h"
#include "Macros.h"
#include "strings/Strings.h"
#include "U8X8/U8X8.h"

/// Display control.
/// \defgroup interfaceDisplay Display
/// \ingroup interface
/// @{

class Display
{
    public:
    Display();
    void init();
    bool update();

    void displayWelcomeMessage();

    void setDirectWriteState(bool state);

    void setupHomeScreen();
    void setupPadEditScreen(uint8_t pad, uint8_t octave, bool forceRefresh = false);
    void setupCalibrationScreen(padCoordinate_t coordinate, bool scrollCalibration);

    void displayProgramInfo(uint8_t program, uint8_t scale, note_t tonic, int8_t scaleShift);
    void displayPad(uint8_t pad = 255);
    void displayActivePadNotes(bool showNotes = true);
    void displayVelocity(uint8_t velocity = 255, int16_t rawPressure = 10000);
    void displayAftertouch(uint8_t aftertouch = 255);
    void displayXYvalue(padCoordinate_t type, midiMessageType_t messageType = midiMessageInvalidType, int16_t value1 = 10000, int16_t value2 = 10000);
    void displayMIDIchannel(uint8_t channel = 255);
    void clearPadPressData();
    void displayDeviceInfo();

    void displayChangeResult(function_t function, int16_t value, settingType_t type);
    void displayError(function_t function, changeResult_t result);

    void displayFirmwareUpdated();
    void displayFactoryResetConfirm();
    void displayFactoryResetStart();
    void displayFactoryResetEnd();

    void displayCalibrationStatus(padCoordinate_t coordinate, bool status);
    void displayPressureCalibrationTime(uint8_t seconds, uint8_t zone, bool done);

    void clearAll();
    void clearRow(uint8_t row);

    void    updateText(uint8_t row, displayTextType_t textType, uint8_t startIndex);
    uint8_t getTextCenter(uint8_t textSize);

    displayTextType_t getActiveTextType();

    private:
    void updateScrollStatus(uint8_t row);
    void updateTempTextStatus();

    /// Holds time index display message was shown.
    uint32_t messageDisplayTime;

    /// Holds last time display was updated.
    /// Display isn't updated in real-time but after defined amount of time (see DISPLAY_REFRESH_TIME).
    uint32_t lastDisplayUpdateTime;

    /// Holds active text type on display.
    /// Enumerated type (see displayTextType_t enumeration).
    displayTextType_t activeTextType;

    /// Array holding still display text for each display row.
    char displayRowStillText[DISPLAY_HEIGHT][STRING_BUFFER_SIZE];

    /// Array holding temp display text for each display row.
    char displayRowTempText[DISPLAY_HEIGHT][STRING_BUFFER_SIZE];

    /// Array holding true of false value representing the change of character at specific location on display row.
    /// \warning This variables assume there can be no more than 32 characters per display row.
    uint32_t charChange[DISPLAY_HEIGHT];

    /// Structure array holding scrolling information for all display rows.
    scrollEvent_t scrollEvent[DISPLAY_HEIGHT];

    /// Holds last time text has been scrolled on display.
    uint32_t lastScrollTime;

    /// Holds state of direct display writing (true/enabled, false/disabled).
    bool directWriteState;
};

/// External definition of Display class instance.
extern Display display;

/// @}
