paradajz/Zvuk9/src/Firmware/board/map/leds/v2.h

#pragma once

#define LED_NOTE_C_SHARP            12
#define LED_NOTE_D_SHARP            11
#define LED_NOTE_F_SHARP            10
#define LED_NOTE_G_SHARP            9
#define LED_NOTE_A_SHARP            8

#define LED_NOTE_C                  22
#define LED_NOTE_D                  21
#define LED_NOTE_E                  20
#define LED_NOTE_F                  19
#define LED_NOTE_G                  18
#define LED_NOTE_A                  17
#define LED_NOTE_B                  16

#define LED_ON_OFF_NOTES            2
#define LED_ON_OFF_AFTERTOUCH       3
#define LED_ON_OFF_X                5
#define LED_ON_OFF_Y                4
#define LED_ON_OFF_SPLIT            6

#define LED_TRANSPORT_PLAY          15
#define LED_TRANSPORT_STOP          14
#define LED_TRANSPORT_RECORD        13

#define LED_OCTAVE_DOWN             1
#define LED_OCTAVE_UP               0
