paradajz/Zvuk9/src/Firmware/board/reset/Reset.cpp

#include "Reset.h"

#define WDFR 3

void disablePeripherals()
{
    //disable eeprom
    EECR = 0;

    //disable analog comparator
    ACSR = 0;

    //disable SPI
    SPCR = 0;

    //disable external interrupts
    EIMSK = 0;

    //disable pin change interrupts
    PCICR = 0;

    //disable ADC
    ADCSRA = 0;

    //disable timers
    TIMSK0 = 0;
    TIMSK1 = 0;
    TIMSK3 = 0;

    //disable USART
    UCSR1B = 0;

    //disable I2C
    TWCR = 0;

    //set all pins to inputs
    DDRB = 0;
    DDRC = 0;
    DDRD = 0;
    DDRE = 0;
    DDRF = 0;

    //write low to all pins
    PORTB = 0;
    PORTC = 0;
    PORTD = 0;
    PORTE = 0;
    PORTF = 0;
}

void reboot()
{
    cli();
    //stop watchdog timer, if running
    MCUSR &= ~(1<<WDFR);
    WDTCSR |= (1<<WDCE);
    WDTCSR = 0;
    _delay_ms(5);
    UDCON = 1;
    USBCON = (1<<FRZCLK);
    _delay_ms(2000);
    disablePeripherals();

    wdt_enable(WDTO_250MS);
    for (;;);
}
