paradajz/Zvuk9/src/Firmware/board/v1/Board.cpp

#include "Board.h"
#include "Variables.h"

Board::Board()
{
    //default constructor
}

void Board::init()
{
    initTimers();
    initEncoders();
    initButtons();
    initLEDs();
    initPads();
};

Board board;
