paradajz/Zvuk9/(commit log)

2016-02-10 fix pad edit mode, misc
    [Encoders.h, LEDs.cpp]
2016-02-11 fix note leds behaviour in pad edit mode
2016-02-11 remove EncoderObject.h
2016-02-14 saner pad mode switching, add x/y axis fliping, add x/y value fliping
    [Defaults.h, Pads.cpp, Pins.h]
2016-02-17 fix inverse y output
    [Pads.cpp]
2016-02-17 fix inverse x output
    [Pads.cpp]
2016-02-17 add prototypes to fix compilation on some systems
2016-02-17 move board variants to special file
2016-02-17 don't track variants to avoid constant switching
2016-03-08 increase lower intensity for leds to avoid flicker
2016-03-08 add padCalibrationStatus section to pad calibratrion memory block
2016-03-08 change default pad calibration ranges to improve interactive calibration detection
2016-03-09 start work on replacing wire library
2016-03-09 replace arduino wire library with i2c_master lib
    [Buttons.cpp, Buttons.h]
2016-03-09 fix i2c
2016-03-10 make includes work on linux/arduino ide again
2016-03-12 switch back to atmel studio, almost all callbacks removed
2016-03-12 fix stop button behaviour
    [Buttons.cpp, Buttons.h, Encoders.cpp]
2016-03-12 improved debugging, fix incorrect pad note retrieval
    [Buttons.cpp, LCD.cpp]
2016-03-13 fix pad edit mode
    [LCD.cpp, Pads.cpp]
2016-03-13 fix incorrect note led setting in pad edit mode
    [LEDs.cpp, Pads.cpp]
2016-03-13 improve modifier button lcd messages
2016-03-13 improved octave led behaviour
2016-03-13 stop button improvements
2016-03-13 stop button led imrovements
2016-03-13 disable encoders in service menu
2016-03-15 fix one modifier bug, introduce another...
    [Buttons.cpp, LCD.cpp]
2016-03-15 hopefully fix all modifier bugs, led behaviour improvements
    [Buttons.cpp, Buttons.h, Encoders.cpp, LCD.cpp]
2016-03-15 fix modifier behaviour in user presets
    [Buttons.cpp]
2016-03-15 remove hardcoded octave display in lcd.cpp, fix activeOctave generating in user scales
    [Buttons.cpp, LCD.cpp, Pads.cpp]
2016-03-15 fix incorrect octave calculation
    [Pads.cpp]
2016-03-15 fix potential bugs regarding eeprom read/write
    [Pads.cpp]
2016-03-16 fix ability to assign note larger than 127, prepare for new tag
    [Buttons.cpp, LCD.cpp]
2016-03-16 fix unstable x/y values, get rid of some unnecessary debouncing as well
    [Defaults.h, LCD.cpp, Pads.cpp]
2016-03-16 restore lower pressure value
2016-03-17 fix a bug when appending text to lcd line
    [LCD.cpp]
2016-03-18 cleanup pad read process, move adc specific stuff to adc.h/adc.cpp, move all pad reading functions to single file PadsHardwareControl.cpp
2016-03-20 test commit - not working
    [LCD.cpp]
2016-03-20 more debug info, broken but improved scrolling
    [LCD.cpp, Pads.cpp]
2016-03-21 fix pad press history buffer
    [Pads.cpp]
2016-03-21 clear velocity from lcd if there are no notes on pad
2016-03-22 note led and aftertouch fixes
2016-03-29 calibration changes
2016-04-30 get rid of strings, replace with c char arrays
    [Encoders.cpp, UpdateLogic.cpp]
2016-05-02 port entire project to avr c/cpp to get rid of arduino framework
2016-05-03 bug fixes, lcd updates
    [Serial.cpp, Serial.h, UpdateLogic.cpp]
2016-05-04 separate public button api from update logic
2016-05-05 ongoing work on service menu and enabling octave shift while pad is pressed - BUGS PRESENT
    [Buttons.cpp]
2016-05-06 hopefully fix octave shift
    [Pads.cpp]
2016-05-09 various lcd and octave shift fixes
    [Buttons.cpp, Buttons.h, Macros.h]
2016-05-09 fix note shifting in predefined scales
    [Pads.cpp, UpdateLogic.cpp]
2016-05-09 simplified debugging using standard printf function
2016-05-09 more service menu fixes
    [Macros.h, UpdateLogic.cpp]
2016-05-11 various lcd tweaks, fixes and improvements
    [Encoders.cpp, UpdateLogic.cpp]
2016-05-12 fix and improve scrolling
    [UpdateLogic.cpp]
2016-05-15 simplify pad calibration functions
2016-05-18 add ability to do factory reset using service menu
    [Init.cpp]
2016-05-20 implement interactive pad calibration
2016-05-27 fix incorrect octave shifting
    [Init.cpp, Pads.cpp]
2016-07-02 various fixes, wip stuff etc
    [Buttons.cpp, Hardware.h, Init.cpp, MenuFunctions.cpp]
2016-07-10 various improvements - eeprom, version checking etc
    [Configuration.h]
2016-07-11 cleanups, misc
    [Configuration.h]
2016-07-18 add midi conf block to eeprom
    [Configuration.h]
2016-07-19 remove quickmenu, act on release for all buttons, new user menu enter mode, new shifting mode, misc
2016-07-19 fix inverted y axis on display
2016-07-21 implement better factory reset inside menu
    [Encoders.cpp, Encoders.h, MenuFunctions.cpp]
2016-07-24 initial work on enabling pressure settings in user menu
2016-07-24 implement selectable async eeprom write
    [Configuration.h]
2016-07-25 fix shift buttons behaviour
    [Buttons.cpp, Buttons.h, Encoders.cpp, MenuFunctions.cpp, MenuFunctions.h, UpdateLogic.cpp]
2016-07-26 implement led blinking for modifer buttons
2016-07-27 fix lcd scrolling bug
    [UpdateLogic.cpp]
2016-07-27 disable buttons while in pad edit mode
2016-08-02 additional fixes for curve storing/showing
    [Macros.h]
2016-08-02 fix incorrect led fade time on startup
    [Init.cpp]
2016-08-07 local tools setup, y curve bug fix
    [Configuration.h]
2016-08-07 versioning improvements
    [Configuration.h]
2016-08-13 further sysex work, usb fixes
    [Buttons.cpp, Config.h, Pads.cpp]
2016-08-16 more sysex work
    [Configuration.h]
2016-08-23 multiple sysex bug fixes
    [Defaults.h, Init.cpp, UpdateLogic.cpp]
2016-08-23 more sysex fixes, misc
    [Init.cpp, Pads.cpp]
2016-09-20 use debug/release config instead of debug.h
    [Configuration.h]
2016-09-26 timer fixes, enable buttons again
    [ISR.cpp, UpdateLogic.cpp]
2016-09-26 fix encoder reading
2016-09-26 fix split on/off message display
    [ISR.cpp, UpdateLogic.cpp]
2016-09-27 refactor ISR routines and timer conf, fix led behaviour
    [Buttons.cpp, ISR.cpp, LEDs.cpp, UpdateLogic.cpp, Variables.h]
2016-09-27 resolve minor led flickering issues caused by switching freq
    [Encoders.cpp, ISR.cpp, LEDs.cpp, Variables.h]
2016-09-27 enable encoders again, start-up animation tweaks
2016-09-28 write factory reset to screen directly in main, misc
    [Configuration.h]
2016-10-06 make leds fade out when performing factory reset using menu
    [MenuFunctions.cpp]
2016-10-08 use gamma correction (2) for pressure
2016-10-09 implement pressure calibration using service menu
2016-10-09 get rid of lower pad pressure variables - use default for all
2016-10-09 add new calibration strings
2016-10-09 add some safety checks when calibrating pressure
2016-10-15 setup fuses when uploading bootloader, comment out external reset source
2016-10-15 don't use gamma correction on pressure
2016-10-19 switch back to o2, o3 messes up i2c (investigate)
2016-10-19 implement pressure sensitivity selection in user menu
    [Configuration.h]
2016-10-22 longer/nicer led fading
2016-10-22 fix inconsistent xy calibration/release behaviour
2016-10-22 fix incorrect notes led behaviour in split mode
2016-10-22 reduce pressure reduction overhead
2016-10-22 better medim/hard pressure sensitivity values
2016-10-22 group pressure sensitivity and curve under single menu group
2016-10-22 switch back to only 3 xy curves (linear, wide ends/middle)
2016-10-22 better pressure scaling on medium/hard settings
2016-10-24 add wrong y setup comments, delete incorrect/unnecessary pinmanipulation lines
    [Pads.cpp]
2016-10-24 add pressure curve setting to user menu
2016-10-24 various xy calibration fixes, pressure curve etc.
    [DataTypes.h, Defaults.h]
2016-10-24 fully implement pressure curve, xy curve fixes
    [DataTypes.h, Defaults.h, MenuFunctions.cpp]
2016-10-31 various midi setting fixes, merge midi/pressure settings into global section
    [Configuration.h]
2016-11-01 fix incorrect reading of transport cc parameter from configuration
    [UpdateLogic.cpp]
2016-11-01 equalised led turn off when performing factory reset
    [LEDs.cpp, MenuFunctions.cpp]
2016-12-17 fix multiple x/y/z min/max/curve bugs
    [DataTypes.h, Defaults.h, Encoders.cpp]
2016-12-19 add package script to zip flash.bin and auto rename it to current version
2016-12-29 replace preset with scale
    [Encoders.cpp]
2016-12-29 disable scale encoder 2 sec after menu exit
2017-01-17 display error when setting tonic on empty pad
    [Buttons.cpp]
2017-01-17 use printf_P everywhere to reduce ram usage
2017-01-17 move reset to board
    [Reset.cpp]
2017-01-17 initial work on implementing handlers for buttons
2017-01-19 implement button handlers using function pointers - simpler logic
2017-01-23 minor refactoring introduce handlers for both encoders and buttons board reorganisation simpler led fading logic misc #
2017-01-28 don't hardcode max number of leds - use column/row math instead
2017-01-28 handle pad switching in board object, move pad mapping to board
2017-01-28 better led fading, implement led blinking
2017-01-29 fix incorrect led state when button is released and disabled
    [Buttons.cpp, Buttons.h, Handlers.cpp]
2017-02-06 fix posibility of deadlock while in menu
    [Buttons.cpp, Database.cpp]
2017-02-07 fix incorrect message when setting already active tonic
    [Handlers.cpp]
2017-02-09 start preparations for board r2
2017-02-09 ongoing work on enabling board r2
2017-02-11 more work on enabling board r2
2017-02-16 working buttons on r2
2017-02-16 enable encoders on r2
2017-03-28 ongoing work on supporting board r2
2017-04-11 direct-write lcd library for board r2, spi, misc
2017-04-21 refactoring kill support for old boards split database into database and dbms move string manipulation to core display tweaks many other changes
2017-04-21 reduce default lower pressure value
2017-04-24 fix hardware version and move hw version to separate file
    [Hardware.h, Version.h]
2017-04-24 calculate new aftertouch limits after setting new pressure level
2017-04-24 use higher value for low pressure limit
2017-04-24 fix incorrect database init
    [Init.cpp]
2017-04-24 use more samples for pressure
2017-04-29 hardware control refactoring - very stable pads, encoders and button not working yet
    [Config.h, DataTypes.h]
2017-05-01 enable encoders again, misc pad tweaks
2017-05-01 fix possible case when notes are sent after pad is released
2017-05-01 pad calibration tweaks
2017-05-01 lower lower pressure limit
2017-05-02 fix aftertouch sensitivity calculation
    [Config.h]
2017-05-06 fix inverse record/stop led index
    [v2.h]
2017-05-06 flush all readings from encoders on startup
2017-05-06 disable scale encoder button while in menu
2017-05-06 remove pad constants from board
2017-05-24 fix incorrect enabling of buttons
    [Buttons.cpp]
2017-05-30 add ability to send only single midi message type if x/y/at/notes button is pressed while pad is pressed
2017-05-31 fix function scaling, rename, organize
    [DataTypes.h, Init.cpp]
2017-05-31 improved single midi message sending while on/off buttons are pressed
2017-06-15 implement all curves (with scaling) correctly
    [DataTypes.h]
2017-06-21 comment out z calibration for now
2017-06-21 initial work on pad pressure calibration zones
2017-06-23 refactored pad calibration, lots of optimizations, lcd update refactoring, misc
2017-06-23 further optimizations, fixes etc.
    [UpdateLogic.cpp]
2017-06-28 return ability to assign curve to pressure
2017-06-28 changed menu navigation click on program button is now enter (next option) click on scale button is now back (previous option)
2017-06-28 speed up fast encoder speed
2017-07-05 rename pressure settings to velocity settings
2017-07-05 velocity sensitivity setting no longer has effect on aftertouch
2017-08-02 remove ROW_SPACING (unused), set correct LCD_WIDTH
    [Config.h]
2017-08-02 reset last step time when handler is called
    [Encoders.cpp]
2017-08-02 get rid of encoder readout time
2017-08-06 doc updates, refactoring, fixes
    [DataTypes.h, Encoders.cpp]
2017-08-07 reduce lower pressure limit
2017-08-15 replace mass storage bootloader with hid
    [Descriptors.c, Descriptors.h, Version.h]
2017-08-15 add pitch bend type to menu/database/getters/setters
2017-08-15 implement pitch bend enabling using cc encoders, pitch bend display (press data), misc
2017-08-17 calibration fixed, remove old btldr, misc
    [Buttons.h, Config.h, Descriptors.c, Descriptors.h]
2017-08-19 stop recording when stop button is pressed
2017-08-19 lots of improvements pressure is now read correctly (finally) gamma function is now used to get better pressure values various lcd improvements, documentation get rid of pressure zones massive ram us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
    [Config.h, DataTypes.h, Database.cpp]
2017-08-23 make sure split is disabled when entering pad calibration
2017-08-23 read upper pressure value directly from database when setting up aftertouch
2017-08-23 tweak aftertouch pressure ratios
2017-08-23 display device name on startup
2017-08-23 velocity/aftertouch pressure ratio tweaks
2017-08-23 use two samles on each sensor plate for pressure
2017-08-25 increase min pad pressure
2017-08-25 more velocty/aftertouch value tweaks
2017-08-25 pressure readout tweaks
2017-08-26 make sure to account for MIN_PAD_PRESSURE when scaling pressure
2017-08-26 more velocity/aftertouch value/ratio tweaks
2017-08-26 improved velocity/pressure reading
2017-08-26 implement pitch bend sending
2017-08-27 fix velocity display on lcd
2017-08-27 fix led states in pad edit mode
    [LEDs.cpp]
2017-08-27 implement pitch bend 0 send
2017-08-27 implement dead pitch bend area for pb type 2
2017-08-27 simplify getMIDIsendState function for pitch bend
2017-08-27 get rid of pressure reduction algorithm, fix aftertouch calculation
2017-08-27 make sure to read same pressure for both velocity and aftertouch
2017-08-27 tweaked pressure reading
2017-08-28 fix pitch bend 2 value calculation
2017-09-01 ignore aftertouch for 200ms after pad has been pressed to avoid incorrect atouch activation
    [Config.h]
2017-09-01 tweak acceleration enable time on encoders
2017-10-30 increase pad pressure resolution
2017-10-31 add schematic and gerbers, curves sheet
    [Curves.xlsx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]
2018-04-09 switch to makefile build system, make code work with new submodules
2018-04-10 reworked led module, documentation updates
    [Handlers.cpp, ISR.cpp, LEDs.cpp]
2018-04-10 reorganize, get rid of button/encoder processing in isr, misc
2018-04-10 add eagle pcb files
    [Zvuk9_R2.brd, Zvuk9_R2.sch]
2018-04-10 fix button enable/disable calls
    [Buttons.cpp, Handlers.cpp]
2018-04-11 documentation, move transition counter array to board
2018-04-11 init usb and uart midi
2018-04-13 move vserial to board
2018-04-13 start preparing for stm32 mcu
2018-04-15 refactoring revamped entire board dir faster pad readout get rid of dim led state (replace with blinking) various other tweaks
    [Board.cpp, Buttons.cpp, Buttons.h, Config.h]
2018-04-15 don't invert y coordinate
    [Pads.cpp]
2018-04-15 init uart transmitter only
2018-04-16 move eeprom access to board
2018-04-17 increase lower pressure value a bit
2018-04-17 correct number of elements in pressure_correction array
2018-04-17 use same approach for press and release pressure samples
2018-04-17 only treat pressure 0 as true pressure 0, everything else is pressure
2018-04-17 new config option to avoid noise for X/Y on low pressure, misc
    [Config.h]
2018-04-17 lower default value for upper pressure
2018-04-17 use correct vid/pid for bootloader
2018-04-18 doxygen fixes, longer blink speed, tweaked led blinking
    [DataTypes.h, LEDs.cpp]
2018-04-23 improved pressure reading
2018-04-23 reduce sample diff
2018-04-23 pressure stability improvement
2018-04-24 reduce minimum pressure
2018-04-24 more pressure reading improvements
2018-05-02 alternative velocity readout
2018-05-02 fix midi printout while calibrating pressure
2018-05-02 better calibration defaults
2018-05-03 increased pressure resolution (initial)
2018-05-03 tweaked pad press pressure due to increased pressure resolution
2018-07-22 board dir refactoring
2018-07-22 handle invert state/pulses internally in board
    [Encoders.cpp, Encoders.h]
2018-07-24 fix descriptors c/p mistake
    [Descriptors.c]
2018-07-24 use much higher default value for upper pressure
2018-07-24 move certain board-specific settings to board dir
2018-07-24 flush all encoder data before starting main loop
2018-07-30 decrease velocity 127 pressure levels
2018-08-06 further v127 pressure level reduction
2018-10-31 fix fuse settings
2018-10-31 fix: always start adc conversion
    [ISR.cpp]
2019-01-20 reduce v127 pressure some more
2019-02-04 pressure tweaking
2021-06-06 remove obsolete files
    [Zvuk9_R2.GBL, Zvuk9_R2.GBO, Zvuk9_R2.GBS, Zvuk9_R2.GKO, Zvuk9_R2.GTL, Zvuk9_R2.GTO, Zvuk9_R2.GTS]
2021-06-12 refactor the entire codebase, port to stm32
    [Zvuk9_R2.brd, Zvuk9_R2.sch]
